ramtuc/rp2040-logic-analyzer/hardware/out/a1/drc-summary.md

# DRC（kicad-cli pcb drc --severity-all --refill-zones）

- 基板: `hardware\rp2040-logic-analyzer.kicad_pcb`
- 未配線: **0**

| severity | type | 件数 |
|:--|:--|--:|
| warning | silk_edge_clearance | 5 |
| warning | silk_over_copper | 8 |
| warning | silk_overlap | 34 |
