ramtuc/rp2040-logic-analyzer/KICAD-KIT.md

# RP2040 ロジックアナライザ — KiCad 着手キット

`SPEC.md` §4〜§10 の確定部品を、KiCad 10 で回路図を描き始められる状態にするための準備資料。**この文書は回路図そのものではない。** 部品の所在・製造制約・ネット名・描き終わったあとの自己点検までを揃える。

- 対象 KiCad: **10.0**（`C:\Program Files\KiCad\10.0`。所在表は**このインストールの実ファイルを直接検索して確認した**もので、他バージョンでは名前が違うことがある）
- 取り込んだライブラリ: `E:\prog\rp2040-logic-analyzer\lib\`
- KiCad プロジェクト: `hardware/rp2040-logic-analyzer.kicad_pro`（**回路図第 1 版は生成スクリプト `tools/gen_schematic.py` の出力**。kicad-cli 10.0.3 の ERC = error 0 / warning 0・§4.1 のネット 86 本と照合 86/86。再現手順は README）
- 作成日: 2026-09-09 ／ **更新: 2026-09-20**（回路図第 1 版 `hardware/rp2040-logic-analyzer.kicad_sch` の実態に合わせて §1.1・§1.2.1・§1.2.4・§1.3・§1.4・§1.5・§2.1・§4.1・§4.2・§5-15・§7 を改訂）

---

## 1. 部品ライブラリ所在表

### 1.1 KiCad 10 標準ライブラリで足りる部品

**シンボルもフットプリントも標準にある。** 追加作業は不要。`FP` 欄に「既定」と書いたものは、シンボルの Footprint プロパティに最初から入っているので、シンボルを置くだけでフットプリントも決まる。

| SPEC BOM # | 参照 | 部品 | シンボル | フットプリント |
|:---|:---|:---|:---|:---|
| 1 | U1 | RP2040 | `MCU_RaspberryPi:RP2040` | `Package_DFN_QFN:QFN-56-1EP_7x7mm_P0.4mm_EP3.2x3.2mm`（**既定**） |
| 2 | U2 | W25Q128JVSIQ | `Memory_Flash:W25Q128JVS` | `Package_SO:SOIC-8_5.3x5.3mm_P1.27mm`（**既定**。SOIC-8 **208mil** の実体。150mil の `SOIC-8_3.9x4.9mm` と間違えないこと） |
| 4 | U7 | AMS1117-3.3 | `Regulator_Linear:AMS1117-3.3` | `Package_TO_SOT_SMD:SOT-223-3_TabPin2`（**既定**） |
| 5 | U8 | USBLC6-2SC6 | `Power_Protection:USBLC6-2SC6` | `Package_TO_SOT_SMD:SOT-23-6`（**既定**） |
| 6 | X1 | ABM8-272-T3 12MHz | `Device:Crystal_GND24`（4 端子・GND が 2/4 番） | `Crystal:Crystal_SMD_3225-4Pin_3.2x2.5mm` |
| 7 | J1 | USB-C 16P（C165948） | `Connector:USB_C_Receptacle_USB2.0_16P` | **`Connector_USB:USB_C_Receptacle_HRO_TYPE-C-31-M-12`** ← C165948 の型番そのものが標準にある |
| 8 | J2 | ピンヘッダ 2×16 | `Connector_Generic:Conn_02x16_Odd_Even` | `Connector_PinHeader_2.54mm:PinHeader_2x16_P2.54mm_Vertical` |
| 9, 10 | J3, J4 | ピンヘッダ 1×3 | `Connector_Generic:Conn_01x03` | `Connector_PinHeader_2.54mm:PinHeader_1x03_P2.54mm_Vertical` |
| — | TP1–TP9 | テストパッド（TP1–TP7 = GP16〜22、**TP8 = SWCLK、TP9 = SWDIO**） | `Connector:TestPoint`（**1 点 1 シンボル**・参照子は TP。旧「J5」を改めた・2026-09-20） | `TestPoint:TestPoint_Pad_1.0x1.0mm` |
| 13 | D1–D3 | LED 赤 0603（C2286） | `Device:LED` | `LED_SMD:LED_0603_1608Metric` |
| 14–21 | R1–R27 | 抵抗 0402 | `Device:R` | `Resistor_SMD:R_0402_1005Metric` |
| 22–25 | C1–C24 | コンデンサ 0402 | `Device:C` | `Capacitor_SMD:C_0402_1005Metric` |
| 26 | C25, C26 | コンデンサ 0805 | `Device:C` | `Capacitor_SMD:C_0805_2012Metric` |

**標準では足りないもの（シンボルは自作 `logicana`／フットプリントは型番固有なので取り込みが要る）— 2026-09-20 差し替え**

| SPEC BOM # | 参照 | 部品 | シンボル | フットプリント |
|:---|:---|:---|:---|:---|
| 11 | SW1 | スライドスイッチ C393948 | **`logicana:SW_SP3T_SK13D07VG5`**（自作・§1.2.4。**2 = COM、1/3/4 = スライダ順の接点、5/6 = 固定ラグ**。2026-10-04 実物で訂正） | `lcsc:SW-TH_SK13D07VG5`（**取り込み**・§1.2。シンボルの Footprint プロパティに設定済み） |
| 12 | SW2, SW3 | タクトスイッチ C318884 | **`logicana:SW_Push_TS1187A`**（自作・§1.2.4。**1+2 と 3+4 が内部導通の 4 パッド**） | `lcsc:SW-SMD_4P-L5.1-W5.1-P3.70-LS6.5-TL_H1.5`（**取り込み**・§1.2。同上） |

> 標準の `Switch:SW_SP3T` / `Switch:SW_Push` は**使わない**。ERC を通ったまま配線が壊れる（理由は §1.2.4）。

### 1.2 標準に無い／LCSC から取り込んだ部品

**不足はシンボル 3（TXU0104PWR・スイッチ 2 種）＋ 型番固有フットプリント 2（スイッチ 2 種）。シンボル 3 個はすべて自作に切り替えた**（§1.2.1・§1.2.4）。残る 2 件（スイッチのフットプリント）は `easyeda2kicad` で取り込む。

**取り込んだファイルの置き場は `lib/lcsc/` に移した。ここは `.gitignore` 済みで、公開リポジトリには入らない**（理由は §1.5）。KiCad からは通常どおり参照できる。

| LCSC | 部品 | 取り込んだシンボル | 取り込んだフットプリント | 実測パッド数 |
|:---|:---|:---|:---|--:|
| **C318884** | タクトスイッチ（SW2, SW3） | `lcsc:TS-1187A-B-A-B` | **`lcsc:SW-SMD_4P-L5.1-W5.1-P3.70-LS6.5-TL_H1.5`** ← 必要 | 4（SMD・5.1×5.1mm） |
| **C393948** | スライドスイッチ（SW1） | `lcsc:SK13D07VG5` | **`lcsc:SW-TH_SK13D07VG5`** ← 必要 | 6（**スルーホール**・信号 4 ＋ 固定ラグ 2） |
| C2286 | LED 赤 0603 | `lcsc:KT-0603R` | `lcsc:LED-SMD_L1.6-W0.8-R-RD` | 2 |
| C165948 | USB-C 16P | `lcsc:TYPE-C-31-M-12` | `lcsc:USB-C_SMD-TYPE-C-31-M-12_1` | 18（信号 16 ＋ 固定 2） |

> **LED と USB-C は標準ライブラリを使うこと。** 取り込んだのは照合用。KiCad 標準の `LED_SMD:LED_0603_1608Metric` と `Connector_USB:USB_C_Receptacle_HRO_TYPE-C-31-M-12` の方がクリアランス・シルク・3D の品質が高い。**`lcsc:` から実際に使うのはスイッチ 2 種のフットプリントだけ。**

### 1.2.1 TXU0104PWR のシンボルは自作した

LCSC 由来のファイルを公開リポジトリに同梱しない方針（§1.5）になったので、**本命の TXU0104PWR は TI データシートから自分で起こした**。格納先は `lib/logicana.kicad_sym`（**`lib/` 配下ではこのファイルだけが追跡対象**）。2026-09-20 の回路図第 1 版で、このファイルに**スイッチ 2 種のシンボル（§1.2.4）と電源シンボル `VREF`** を追記し、計 4 シンボルになっている。

| 項目 | 内容 |
|:---|:---|
| シンボル | **`logicana:TXU0104PWR`** |
| フットプリント | **`Package_SO:TSSOP-14_4.4x5mm_P0.65mm`（KiCad 標準）** をプロパティに設定済み |
| 出典 | TI **SCES937B**（2026-02 改訂）**Table 4-1**「PW, BQA」列 |

**ピン配置（TI Table 4-1 そのまま）**

| ピン | 1 | 2 | 3 | 4 | 5 | 6 | 7 | 8 | 9 | 10 | 11 | 12 | 13 | 14 |
|:---|:--|:--|:--|:--|:--|:--|:--|:--|:--|:--|:--|:--|:--|:--|
| 名前 | VCCA | A1 | A2 | A3 | A4 | NC | GND | OE | NC | B4Y | B3Y | B2Y | B1Y | VCCB |
| 種別 | power_in | input | input | input | input | no_connect | power_in | input | no_connect | output | output | output | output | power_in |

**確認の取り方（再現できる）**

1. `kicad-cli sym upgrade lib/logicana.kicad_sym` → **「シンボル ライブラリは更新されていません」**＝ KiCad 10 が現行形式として問題なく読めている（構文エラーなら失敗する）
2. `kicad-cli sym export svg --symbol TXU0104PWR lib/logicana.kicad_sym` → 描画まで通る
3. 14 ピン全部の `number` / `name` / 電気的タイプを上の表と機械的に突き合わせ、**14/14 一致・番号の重複なし**を確認済み

**フットプリントは TI の推奨ランドと照合済み。**

| | TI PW0014A 推奨ランド（図面 4220202/B） | KiCad `TSSOP-14_4.4x5mm_P0.65mm` |
|:---|:---|:---|
| ピッチ | **0.65mm** | **0.65mm**（一致） |
| パッド寸法 | 0.45 × 1.5mm | 0.40 × 1.475mm |
| 列間（中心‐中心） | 5.8mm | 5.725mm |

KiCad 側は IPC-7351 の公称値で **TI の例より 0.05〜0.075mm 小さいだけ**。TI 自身が図面注記 6 で「Publication IPC-7351 may have alternate designs」と書いており、**そのまま使ってよい**。

### 1.2.2 SW1（C393948 / SK13D07VG5）— データシートで 3 点確定した

前回「パッド間隔が非対称で怪しい」と保留にしていた件を、メーカー図面（首韩科技 SK13D07VG5・図面 2021-06-09 版・LCSC 配布 PDF）で確定させた。

| 論点 | 結論 |
|:---|:---|
| **非対称なパッド間隔は正しい** | 図面の `P.C.B LAYOUT BOTTOM VIEW` と端子側面図の寸法連鎖が **4 / 2 / 2mm（4 ピンで全長 8mm）**。取り込んだフットプリントの x = −4.00 / 0.00 / +2.00 / +4.00 と**完全一致**。固定ラグを含めた全幅は 12.3mm。**修正不要** |
| ~~コモンはピン 1~~ → **コモンはピン 2（2026-10-04 実物で訂正）** | 当初は、図面の `SCHEMATIC (SHORTING)` で左端の端子だけが実線でスライダにつながり、ピン 1 だけが隣から 4mm 離れて残り 3 本が 2mm ピッチ（スライダの移動量）で並ぶ配置と符合する、と読んだ。**実物をテスターで当てるとコモンはピン 2（孤立したピン 1 の隣）**で、スライダ位置ごとにピン 2 がピン 1 / 3 / 4 とつながる。図の読み取りも配置からの推論も外れていた（SPEC §17） |
| **shorting（make-before-break）型** | 図のタイトルが **`SCHEMATIC (SHORTING)`**。→ §1.2.3 の設計上の制約につながる |
| 実装形態 | **THT・ライトアングル**。SPEC §10 の「SMD」は誤りだったので修正済み。手はんだ組（ピンヘッダ 3 点 ＋ SW1 の計 4 点）に入れた |

**SMD の SP3T に替えなかった理由**は SPEC §10 末尾の注記のとおり。候補（MSK13C02 / C2681567・在庫 18,966・$0.1164）はあったが、**コモンがどのピンか・shorting かどうかがデータシートから読み取れない**ため採らなかった。

### 1.2.3 SW1 が shorting 型であることの帰結 ★見落とすと壊れる

**切り替えの途中で隣り合う 2 接点が短絡する。** VREF の 3 択は電源レールを選ぶ回路なので、接点の並べ方を間違えると **+3V3（LDO 出力）と +5V（USB VBUS）が直結**する。3.3V レールは LDO が電流を吸えないので押し上げられ、**RP2040 の IOVDD 絶対最大定格 3.63V を超えうる**。

**対策は接点の並び順だけ。部品代は 0 円。**

```
pad (physical):  1        2        3        4
net:             +3V3     VREF     EXT(J3)  +5V
role:            throw    COM      throw    throw

slider position   COM(pad2) connects to
"3.3V"            pad1 = +3V3      <- end
"EXT"             pad3 = EXT (J3)  <- in the middle
"5V"              pad4 = +5V       <- end
```

> **2026-10-04 訂正**: 第 1 版はピン 1 = コモン（ピン 2 = +3V3）としてこの図を描いていた。実物はピン 2 がコモン（§1.2.2）。上の図が正しい割り当てで、スライダ順「3.3V ― EXT ― 5V」の意図は変わらない。A0 基板は部品側のジャンパで改修済み、PCB は次版で直す（SPEC §17）

こうすれば **+3V3 と +5V は決して隣り合わない**。橋渡しが起きるのは「3V3 ↔ EXT」と「EXT ↔ 5V」で、EXT は未接続が既定なので実害が無い。**EXT に外部電源を挿したままスライドさせない**ことだけシルクか記事で伝える。

> **2026-09-20 追記（回路図レビュー #3）**: この「EXT に外部電源を挿したままスライドさせない」は、EXT を真ん中に置いても解消しない制約（EXT 接続中の切替では、途中で外部電源と内蔵 3.3V または 5V が一時的に直結する。外部電源への逆流も防げない）。**SPEC §6.1「使い方」に運用制約として格上げ**した。手順は「J3 の EXT ケーブルを外す → SW1 で位置を選ぶ → 接続する」。通電中の切替を許容するなら次リビジョンで non-shorting 型か逆流防止を入れる。**初版は回路を変えない**（人間決定）。

### 1.2.4 スイッチのシンボルは自作に差し替えた（2026-09-20・回路図第 1 版で確定）

KiCad 標準の `Switch:SW_SP3T` / `Switch:SW_Push` を §1.2 のフットプリントと組み合わせると、**ERC を通ったまま配線が壊れる**。シンボルのピン番号がそのままパッド番号に対応するので、番号付けが現物のパッド配置と食い違う部品では誤配線が ERC に出ない。

| 参照 | 標準シンボルの問題 | 自作シンボル（`lib/logicana.kicad_sym`） |
|:---|:---|:---|
| SW1 | `Switch:SW_SP3T` は**コモンがピン 3**（描画で確認: 左の単独ピンが 3、右が 1/2/4）。物理はピン 2 がコモン（§1.2.2・2026-10-04 実物で訂正）なので、番号どおり繋ぐと**コモンがパッド 3 に行く** | **`SW_SP3T_SK13D07VG5`** — ピン番号 = 物理パッド番号。**2 = COM、1/3/4 = スライダ順の接点、5/6 = 固定ラグ（MNT・未接続）**。接続は pin2 = `VREF` / pin1 = `+3V3` / pin3 = `VREF_EXT` / pin4 = `+5V`（§5-12 の並びどおり）。**2026-10-04 訂正**: 回路図第 1 版は 1 = COM として pin1 = `VREF` / pin2 = `+3V3` で描いており、実物ではコモンが +3V3 側になっていた。シンボルのピン番号を実物に合わせて直した（配線は不変） |
| SW2, SW3 | `Switch:SW_Push` は 2 ピン。TS-1187A は 4 パッドで、**パッド 1–2（A–B）が内部で常時導通、3–4（C–D）が反対側**（XKB 図面 TS-1187A-X-X-X の回路図・LCSC 配布 PDF で確認。EasyEDA シンボルの A–B 結線とも一致）。2 ピンシンボルを 4 パッドに当てるとピン 1/2 → パッド 1/2 になり、**押していなくても常時短絡**（RUN / BOOT が GND に張り付く＝永久リセット） | **`SW_Push_TS1187A`** — 1+2 を同一点に、3+4 を同一点にスタックした 4 ピン。4 パッド全部にネットが付き、接点の対（1+2 ↔ 3+4）だけがスイッチになる |

どちらも `ki_fp_filters` を `lcsc` のフットプリント名に合わせ、Footprint プロパティに §1.2 の型番固有フットプリントを設定済み。`kicad-cli sym upgrade`（「更新されていません」＝ 10.0 形式として正常）と `sym export svg`（3/3 成功）で読めることを確認している。LCSC 由来のシンボル（`lcsc:SK13D07VG5` / `lcsc:TS-1187A-B-A-B`）は照合にだけ使い、回路図には埋め込まない（§1.5 の方針）。

### 1.3 取り込みを再現する手順

```
py -m pip install --user easyeda2kicad          # 導入済み: v1.0.1
```

必要なのは**スイッチ 2 種のフットプリント**。LED と USB-C は照合用（標準ライブラリを使うので任意）。

```
py -m easyeda2kicad --full --project-relative --lcsc_id C318884 --output E:/prog/rp2040-logic-analyzer/lib/lcsc/lcsc --overwrite
py -m easyeda2kicad --full --project-relative --lcsc_id C393948 --output E:/prog/rp2040-logic-analyzer/lib/lcsc/lcsc --overwrite
py -m easyeda2kicad --full --project-relative --lcsc_id C2286   --output E:/prog/rp2040-logic-analyzer/lib/lcsc/lcsc --overwrite
py -m easyeda2kicad --full --project-relative --lcsc_id C165948 --output E:/prog/rp2040-logic-analyzer/lib/lcsc/lcsc --overwrite
```

`--full` で **シンボル・フットプリント・3D モデル（wrl と step 両方）** が出る。`--output` はライブラリ名の接頭辞で、次の 3 つが作られる。

```
lib/lcsc/lcsc.kicad_sym      シンボル（全部品が 1 ファイルに追記される）
lib/lcsc/lcsc.pretty/        フットプリント（1 部品 1 ファイル）
lib/lcsc/lcsc.3dshapes/      3D モデル
```

> **`--project-relative` を必ず付ける。** 付けないと 3D モデルのパスが**絶対パスで埋め込まれ**、リポジトリを別の場所に置いた瞬間に 3D が出なくなる。付ければ `${KIPRJMOD}/lib/lcsc/lcsc.3dshapes/...` になる（取り込み済みのものは確認済み）。**ただしプロジェクトは `hardware/` 配下なので（§1.4）、フットプリントを基板に取り込む段でこのパスを `${KIPRJMOD}/../lib/lcsc/lcsc.3dshapes/...` に書き換える。** 3D 表示だけの問題で製造データには影響しない。

> **必須の後処理**: easyeda2kicad v1.0.1 が書き出すフットプリントは **KiCad 5 時代の `(module ...)` 形式**（`tedit` 付き）。KiCad 10 でも読めるが、そのままだと保存のたびに変換が走る。**一度だけ次を実行して KiCad 10 形式に上げておく**（実行済み・戻り値 0、`(footprint ... (version 20260206))` に変換されたことを確認済み）。
>
> ```
> "C:\Program Files\KiCad\10.0\bin\kicad-cli.exe" fp  upgrade E:\prog\rp2040-logic-analyzer\lib\logicana.pretty
> "C:\Program Files\KiCad\10.0\bin\kicad-cli.exe" sym upgrade E:\prog\rp2040-logic-analyzer\lib\logicana.kicad_sym
> ```

### 1.4 ライブラリの登録

プロジェクトは **`hardware/rp2040-logic-analyzer.kicad_pro`**（リポジトリ直下ではなく `hardware/` 配下・2026-09-20 確定）。登録は**プロジェクト固有**（グローバルではない）で、`hardware/sym-lib-table` と `hardware/fp-lib-table` に生成済み。`${KIPRJMOD}` が `hardware/` を指すので、パスはすべて **`${KIPRJMOD}/../lib/...`** になる。

| 種別 | メニュー | ニックネーム | パス | git |
|:---|:---|:---|:---|:---|
| シンボル（**自作**） | 設定 → シンボルライブラリを管理 → **プロジェクト固有**タブ | `logicana` | `${KIPRJMOD}/../lib/logicana.kicad_sym` | **追跡する** |
| シンボル（LCSC 由来） | 同上 | `lcsc` | `${KIPRJMOD}/../lib/lcsc/lcsc.kicad_sym` | `.gitignore` |
| フットプリント（LCSC 由来） | 設定 → フットプリントライブラリを管理 → **プロジェクト固有**タブ | `lcsc` | `${KIPRJMOD}/../lib/lcsc/lcsc.pretty` | `.gitignore` |

3D モデルのパスも同じく `${KIPRJMOD}/../lib/lcsc/lcsc.3dshapes/...` にする。easyeda2kicad が埋め込むのは `${KIPRJMOD}/lib/...`（ルート前提）なので、**フットプリントを基板に取り込む段で `../` を足す**（§1.3）。`${KIPRJMOD}` 相対である限り、リポジトリを別の場所へ移しても壊れない。

### 1.5 ライセンス — **2026-09-09 に方針確定**

**LCSC / EasyEDA 由来のファイルは公開リポジトリに同梱しない。** そのために本命の TXU0104PWR は自作に切り替え（§1.2.1）、残りは `lib/lcsc/` にまとめて `.gitignore` した。README に取り込みコマンドを載せてあるので、読者は自分で生成できる。

| 対象 | ライセンス | この基板での扱い |
|:---|:---|:---|
| **KiCad 標準ライブラリ**（symbols / footprints / 3dmodels） | **CC-BY-SA 4.0 ＋ 例外条項** | 公式 License ページが「ライブラリを使って作った電子設計が Adapted Material に当たるとしても著作権者は権利を放棄する」旨を明記しており、**この基板を CERN-OHL-P-2.0 で出すことと衝突しない**。ただし**ライブラリ自体を再配布するなら CC-BY-SA 4.0 と帰属表示が必要**。→ **`lib/` に標準ライブラリのコピーを置かない**（参照するだけ） |
| **`lib/logicana.kicad_sym`（TXU0104PWR・SW_SP3T_SK13D07VG5・SW_Push_TS1187A・VREF の 4 個・自作）** | **この基板と同じ CERN-OHL-P-2.0** | TI SCES937B Table 4-1 とメーカー図面（SK13D07VG5 / TS-1187A）のピン割り当てを読んで自分で描いたもの。**追跡・同梱する** |
| **easyeda2kicad.py**（ツール） | **AGPL-3.0**（パッケージメタデータで確認） | ツールを実行しただけで出力物にライセンスは及ばない |
| **`lib/lcsc/`（LCSC / EasyEDA 由来）** | **明示的なオープンライセンスを確認できなかった（未確認）** | **`.gitignore` 済み・同梱しない。** 読者は README のコマンドで各自生成する |
| **3D モデル（`.step` / `.wrl`）** | 同上 | **同梱しない**（`lib/lcsc/` ごと除外）。容量も 14MB あり、リポジトリに載せる意味が薄い |

---

## 2. JLCPCB PCBA 用の BOM / CPL を KiCad から出す

### 2.1 まずシンボルにフィールドを足す

**回路図を描き始める前に決めておくと後で全部品を触り直さずに済む。** JLCPCB 公式の KiCad 10 向け記事は、フィールド名を **`LCSC Part #`** にせよと書いている（「Click the (Add Field) button on the left and create a field named **LCSC Part #**」）。

`Fabrication Toolkit`（bennymeg）は README のとおり、次の順で探す。**公式記事に合わせて `LCSC Part #` を使えば両方の経路で通る。**

| 優先 | フィールド名 |
|:---|:---|
| 1（主） | `LCSC Part #` / `LCSC Part` / `LCSC PN` / `LCSC P/N` / `LCSC Part No.` / `LCSC Part Number` |
| 1（主） | `JLCPCB Part #` ほか同型 |
| 2（代替） | `LCSC` / `JLC` / `MPN` / `Mpn` / `mpn` |

> **DNF 部品**（R23 の QSPI_SS プルアップ、J4 の DNF）は `LCSC Part #` を**空にする**か、シンボルプロパティの **Do not populate (DNP)** を立てる。Fabrication Toolkit には「Exclude DNP components from BOM」のオプションがある。

**フィールド名は `LCSC Part #` に統一する（2026-09-20 確定）。** 回路図第 1 版は全部品にこの名前で入れてあり、kicad-cli の `sch export bom --fields "Reference,Value,Footprint,LCSC Part #,QUANTITY,DNP"`（経路 B 相当・README の再現手順）でも列に出ることを確認済み。R23 は DNP ＋ `LCSC Part #` 空、J4 も DNP で、JLCPCB 向け `bom-jlcpcb.csv` からは除外される。

### 2.2 出力の 2 経路

| | 経路 A: **Fabrication Toolkit**（推奨） | 経路 B: KiCad 10 標準機能のみ |
|:---|:---|:---|
| BOM | プラグインが自動生成 | 回路図エディタ → **ツール → シンボルフィールドテーブルを編集** → **エクスポート**タブ → Format presets を **CSV** |
| CPL | プラグインが `positions.csv` を生成 | PCB エディタ → **ファイル → 基板製造用ファイル出力 → 部品配置ファイル (.pos)**。単位 **mm**、**CSV**、両面を 1 ファイル |
| 回転補正 | **自動**（後述） | **手動**。JLCPCB 公式記事は経路 B について回転補正の手順を書いていない |
| ガーバー | 同時に出る | 別途出力 |

JLCPCB が要求する列名（公式記事より）:

- **BOM**: `Comment` / `Designator` / `Footprint` / `JLCPCB Part #`
- **CPL**: `Designator` / `Mid X` / `Mid Y` / `Rotation` / `Layer`（**mm・回転は反時計回りが正**）

### 2.3 フットプリントの原点と回転のずれ — 補正は要るのか

**要る。ただし手作業ではなく仕組みで吸収する。**

JLCPCB 側の前提は「**PCB ライブラリのゼロ度の向きが、テープ／リールに入っている部品の向きと一致していること**」。KiCad 標準ライブラリはこの前提に合っていない部品が多いので、そのまま CPL を出すと極性部品（LED・ダイオード・IC）が 90° / 180° ずれる。

| 手段 | 内容 |
|:---|:---|
| **Fabrication Toolkit の自動補正**（これを使う） | README に「Most of the rotations may be corrected by the **`rotations.cf`** definitions」。プラグイン内蔵の補正データベースが、フットプリント名の正規表現で回転量を当てる |
| 例外が出たとき | シンボルに **`FT Rotation Offset`** フィールドを足し、**反時計回りの度数**を入れる（代替名 `Rotation Offset` / `RotOffset`） |
| 位置がずれるとき | **`FT Position Offset`** に `x,y` をカンマ区切り・mm で入れる（代替名 `Position Offset` / `PosOffset`） |
| 原点そのものを変えたいとき | **`FT Origin`** に `Anchor` または `Center` |
| JLCPCB 標準機能の逃げ道 | 公式が「向きが分からなければ JLCPCB のエンジニアがシルクの表示を見て組み立て前に回転と極性を直す」と書いている。**最後の保険であって、当てにして出すものではない** |
| 経路 B を使う場合 | 「**Apply automatic component translations** にチェックを入れたままにする（JLCPCB 向けに部品の回転／位置を直す）」と公式記事が書いている |

> **今回この基板で特に危ないのは 3 つ。** ①**LED（D1–D3）の極性** — 0603 LED は補正データベースの常連。②**USB-C（J1）** — 標準の `USB_C_Receptacle_HRO_TYPE-C-31-M-12` は原点がコネクタ中心で、LCSC のテープ向きと一致する保証が無い。③**AMS1117（SOT-223）** — タブの向き。**この 3 つは、発注前に JLCPCB の注文画面の 3D プレビューで必ず目視すること。** ガーバーをアップロードすると部品の向きが表示される。

---

## 3. JLCPCB 4 層の製造能力と KiCad の Board Setup

### 3.1 スタックアップ（Board Setup → 基板スタックアップ）

JLCPCB 公式のインピーダンス用スタックアップ一覧より、**1.6mm 4 層の標準は `JLC04161H-7628`**。KiCad の物理スタックアップにそのまま入れる値:

| 層 | 材料 | 厚み | 誘電率 Dk |
|:---|:---|--:|--:|
| F.Cu | 銅 1oz | **0.035mm** | — |
| Dielectric 1 | **プリプレグ 7628 ×1** | **0.2104mm** | **4.4** |
| In1.Cu | 銅 0.5oz | **0.0152mm** | — |
| Dielectric 2 | **コア** | **1.065mm** | **4.6** |
| In2.Cu | 銅 0.5oz | **0.0152mm** | — |
| Dielectric 3 | **プリプレグ 7628 ×1** | **0.2104mm** | **4.4** |
| B.Cu | 銅 1oz | **0.035mm** | — |
| | | **合計 1.586mm ≒ 1.6mm** | |

同じ 1.6mm 4 層で選べる別案（プリプレグが薄くなる＝外層と GND が近づく）:

| 名前 | 外層プリプレグ | Dk | コア |
|:---|--:|--:|--:|
| `JLC04161H-7628` ✅ | 0.2104mm | 4.4 | 1.065mm |
| `JLC04161H-2116` | 0.1164mm | 4.16 | 1.265mm |
| `JLC04161H-3313` | 0.0994mm | 4.1 | 1.265mm |
| `JLC04161H-1080` | 0.0764mm | 3.91 | 1.265mm |

**`JLC04161H-7628` を選ぶ。** 公式が「計算機が最初に薦めるスタックアップが最も安く納期も早い」と書いており、7628 が既定。プリプレグが薄い案は USB の線幅が細くなりすぎる。

> **層の役割**: L1 = 部品と信号 ／ **L2 = 切れ目のない GND ベタ** ／ L3 = 電源（+3V3・+5V・VREF） ／ L4 = 信号と GND。SPEC §8.1 の「16 本の高速入力の下に切れ目のない GND」は L2 が担う。

### 3.2 Design Rules（Board Setup → デザインルール → 制約）

JLCPCB 公式 capabilities ページの多層基板・外層 1oz の値。**括弧内はこの基板で実際に入れる推奨値**（最小値ぎりぎりで引くと歩留まりと DFM 指摘のリスクが上がるので、余裕を取る）。

| KiCad の項目 | JLCPCB の限界 | **入れる値** |
|:---|:---|:---|
| 最小クリアランス | 0.09mm（3.5mil・1oz 多層） | **0.15mm** |
| 最小トラック幅 | 0.09mm（3.5mil・1oz 多層） | **0.15mm** |
| 最小ビア直径 | 0.25mm | **0.45mm** |
| 最小ビアドリル | 0.15mm | **0.25mm** |
| 最小スルーホール径 | 0.15mm（ドリル範囲 0.15〜6.3mm） | **0.30mm** |
| 最小アニュラリング | 0.15mm（**推奨 0.20mm 以上**） | **0.10mm**（＝ビア 0.45／ドリル 0.25 で片側 0.10mm。**JLCPCB の推奨 0.20mm を満たすなら 0.65/0.25 にする**） |
| 最小シルク線幅 | ≥0.15mm | **0.15mm** |
| 最小ソルダーマスクダム（ブリッジ） | 0.10mm（1oz） | **0.10mm** |
| 基板端からの銅箔クリアランス | ≥0.2mm | **0.3mm** |
| 銅厚 | 外層 1oz / 2oz、内層 0.5oz（既定）/ 1oz / 2oz | **外層 1oz・内層 0.5oz** |
| トラック幅公差 | ±20% | — |
| 穴位置公差 | ±0.05mm | — |

> **未取得**: 「穴と穴の最小間隔」「ビアとトラックの最小間隔」は capabilities ページの取得範囲に無かった（**未確認**）。ガーバーを上げると走る **JLCPCB の DFM チェックで確認する**のが確実。

### 3.3 ネットクラス（Board Setup → デザインルール → ネットクラス）

| ネットクラス | 対象ネット | トラック幅 | クリアランス | ビア径/ドリル | 差動 |
|:---|:---|--:|--:|:---|:---|
| `Default` | 上記以外 | 0.20mm | 0.15mm | 0.45/0.25 | — |
| `Power` | `+5V` `+3V3` `VREF` `DVDD` | **0.50mm** | 0.20mm | 0.65/0.35 | — |
| `USB` | `USB_DP` `USB_DM`（コネクタ側） | **0.30mm** | 0.15mm | 使わない | **幅 0.30mm / ギャップ 0.15mm** |
| `Signal_D` | `D0`〜`D15` | 0.20mm | 0.15mm | 0.45/0.25 | — |
| `QSPI` | `QSPI_SCLK` `QSPI_SS_N` `QSPI_SD0`〜`SD3` | 0.20mm | 0.15mm | 使わない | — |

### 3.4 USB 2.0 の 90Ω 差動ペア

**Raspberry Pi 公式の前提**（Hardware design with RP2040 §2.4.1）:

> 「RP2040 はフルスピード 12Mbps に限られるとはいえ、伝送線路の特性インピーダンスを USB 規格の **90Ω（差動）**に近づけるべきである。**この 1mm 厚の基板では、USB_DP / USB_DM に 0.8mm 幅、間隔 0.15mm を使えば約 90Ω になる**」
> 「**1mm より厚い基板を選ぶ場合**は、トラックと直下の GND の距離が増えた分を**再設計するか**、無視して祈るかの二択になる」

**この基板は 1.6mm 4 層なので「再設計する」側。** ただし 2 層 1mm と違い、**外層のすぐ下（0.2104mm）に L2 の GND ベタが来る**ので、距離はむしろ**縮む**。したがって公式の 0.8mm より**細くなる**。

`JLC04161H-7628` の外層（H = 0.2104mm、Dk = 4.4、銅 0.035mm）でエッジ結合マイクロストリップとして計算した値:

| 間隔 S | 90Ω 差動になる幅 W | そのときの単線 Z0 |
|--:|--:|--:|
| 0.13mm | 0.283mm | 61.2Ω |
| **0.15mm** | **0.300mm** | 59.4Ω |
| 0.20mm | 0.336mm | 55.7Ω |
| 0.25mm | 0.365mm | 53.2Ω |

**採用: 幅 0.30mm / 間隔 0.15mm。** 参考までに、同じ層で 50Ω 単線にするなら 0.405mm。

> **この 4 つの数字は自分で計算した参考値であって、JLCPCB の公式値ではない。** IPC-2141 系のマイクロストリップ近似（Hammerstad ＋ 差動補正）で解いたもので、実装誤差やソルダーレジストの影響は入っていない。
>
> **公式のインピーダンス計算機との突き合わせはできなかった（未確認・2026-09-09）。** `jlcpcb.com/pcb-impedance-calculator` は入力も計算もブラウザ側で完結する SPA で、HTML にも読み込まれる JS にも**照会できる API が無い**。値を取るには実際にブラウザで操作するしかない。**発注前に人間が計算機に「4 層・1.6mm・差動・トップ層・90Ω」を入れて突き合わせること。**
>
> **そのうえで、今回は「インピーダンス制御」を注文しない前提でよい。** 相手は 12Mbps のフルスピードで、Raspberry Pi 公式自身が「USB FS はかなり寛容」と書いている。制御を注文すると費用と納期が増える。**やるべきは「線幅を合わせる」「直下を GND ベタだけが通るようにする」の 2 点**で、これは無料。仮に実測が 90Ω から 1 割ずれても FS では実害が出ない。

---

### 3.5 PCBA 側の制約（JLCPCB 公式 assembly capabilities）

| 項目 | Economic PCBA | 備考 |
|:---|:---|:---|
| 最小部品サイズ | **0402** | この基板の最小は 0402。**ぎりぎり通る**（Standard なら 0201 まで） |
| スルーホール部品 | **対応する**（SMD ＋ THT の混載も可） | SW1・J2〜J4 が該当。ただし手はんだ工賃は SPEC §14-5 の判断どおり |
| 実装面 | 片面 / 両面 | **片面（top のみ）で設計する**。両面にすると費用が増える |
| 基板サイズ | 10×10mm 〜 470×500mm | SPEC §8.3 のサイズなら問題なし |
| 面付けレール | **不要** | Standard PCBA だと必要になる |

---

## 4. ネット名とシート構成

### 4.1 ネット名（SPEC §7 のピン割り当てをそのまま名前にする）

**1ch あたりネットが 3 本になる**（ヘッダ → 100Ω → TXU0104 A ピン → B ピン → RP2040）。名前を機械的に決めておくと、フロントエンドのシートを 4 回使い回すときに迷わない。

| 区間 | ネット名 | 本数 | 行き先 |
|:---|:---|--:|:---|
| J2 の内側 1 列 → R（100Ω） | `CH0_IN` 〜 `CH15_IN` | 16 | プローブが刺さる先 |
| R（100Ω） → TXU0104 の A ピン | `CH0_A` 〜 `CH15_A` | 16 | A1〜A4 ×4 個 |
| TXU0104 の B ピン → RP2040 | **`D0` 〜 `D15`** | 16 | **GP0〜GP15**（ファームのチャンネル番号と一致させる） |

| 用途 | ネット名 | 接続先 |
|:---|:---|:---|
| USB VBUS | `+5V` | J1 VBUS → SW1 の 5V 接点、AMS1117 IN |
| 3.3V レール | `+3V3` | AMS1117 OUT。RP2040 IOVDD ×6・USB_VDD・ADC_AVDD、TXU0104 の VCCB ×4 |
| **A 側基準電圧** | **`VREF`** | SW1 コモン → TXU0104 の VCCA ×4、D2 |
| RP2040 内蔵レギュレータ出力 1.1V | `DVDD` | VREG_VOUT(45) → DVDD(23, 50) |
| USB（RP2040 側・27Ω より内側） | `USB_DP_MCU` `USB_DM_MCU` | RP2040 ↔ R19 / R20 |
| **USB（コネクタ側・長い方）** | **`USB_DP` `USB_DM`** | R19 / R20 ↔ USBLC6 ↔ J1。**ネットクラス `USB` を当てるのはこちら** |
| USB-C の CC | `CC1` `CC2` | 5.1kΩ で GND（**各 1 本・独立**） |
| 水晶 | `XIN` `XOUT`（1kΩ の外側は `XTAL_DRV`） | RP2040 ↔ R21 ↔ X1 |
| フラッシュ | `QSPI_SCLK` `QSPI_SS_N` `QSPI_SD0` 〜 `QSPI_SD3` | RP2040 ↔ U2（直結・最短） |
| BOOTSEL | `USB_BOOT` | SW2 → R22(1kΩ) → `QSPI_SS_N` |
| リセット | `RUN` | SW3 → GND |
| **レベル変換の出力許可** | **`TXU_OE`** | **GP23** ＋ 10kΩ で **`+3V3` へ**プルアップ（§5-10） |
| ステータス LED | `LED_STATUS` | GP25 → R27 → D3 |
| **VREF の外部入力** | **`VREF_EXT`** | SW1 pin3 ↔ J3 pin2（J3 pin1/3 は GND）。2026-09-20 命名 |
| テストパッド | `GP16` 〜 `GP22` | TP1〜TP7（1 点 1 シンボル・7 点） |
| **SWD** | **`SWCLK` `SWDIO`** | U1 pin24 / pin25 → **TP8 / TP9**（2026-09-20 決定・§5-15） |
| アナログ | `GP26_ADC0` `GP27_ADC1` `GP28_ADC2` | J4（DNF） |
| グラウンド | `GND` | 全面。**J1 SHIELD → GND 直結**（Pico と同じ扱い）、**U1 TESTEN(19) → GND**（RP2040 データシートのピン説明「Factory test mode enable. Ground on user boards」） |

### 4.2 階層シート分割案

> **回路図第 1 版（2026-09-20）は平面 1 シート（A3）で生成した。** 結線はローカルラベル（§4.1 の名前そのまま）で決まるので、GUI で整形するときに以下の分割へ移してもネットは変わらない。以下は分割する場合の案。

```
rp2040-logic-analyzer.kicad_sch          ルート（シートシンボルだけを置く）
├── 01_power.kicad_sch                   J1(USB-C) / U8(ESD) / U7(LDO) / SW1(VREF 3択) / D1 / D2
├── 02_mcu.kicad_sch                     U1(RP2040) / U2(Flash) / X1 / SW2 / SW3 / D3 / TP1〜TP9
├── 03_frontend.kicad_sch  ×4 インスタンス  U3〜U6（TXU0104 1 個ぶん = 4ch）
└── 04_connectors.kicad_sch              J2(2×16 プローブヘッダ) / J3(VREF EXT) / J4(アナログ DNF)
```

**フロントエンドは 1 枚のシートを 4 回使い回す。** KiCad は同じ回路図ファイルを複数のシートシンボルから参照でき、注釈（R1 と R5 のような参照子）はインスタンスごとに別々に振られる。**4 回描き写すより間違いが 4 分の 1 になる。**

`03_frontend.kicad_sch` の階層ピン（1 インスタンスあたり 10 本）:

| 階層ピン | 向き | ルート側で繋ぐもの（インスタンス 1 の例） |
|:---|:---|:---|
| `IN0` 〜 `IN3` | input | `CH0_IN` 〜 `CH3_IN` |
| `OUT0` 〜 `OUT3` | output | `D0` 〜 `D3` |
| `VREF` | power in | `VREF` |
| `OE` | input | `TXU_OE` |

`+3V3` と `GND` は電源シンボルで各シートに直接置く（階層ピンにしない）。

| インスタンス | シート名 | IN | OUT |
|:---|:---|:---|:---|
| 1 | `FE_A` (U3) | `CH0_IN`〜`CH3_IN` | `D0`〜`D3` |
| 2 | `FE_B` (U4) | `CH4_IN`〜`CH7_IN` | `D4`〜`D7` |
| 3 | `FE_C` (U5) | `CH8_IN`〜`CH11_IN` | `D8`〜`D11` |
| 4 | `FE_D` (U6) | `CH12_IN`〜`CH15_IN` | `D12`〜`D15` |

> **`CHn_A`（100Ω と A ピンの間）はシートの中で閉じるので、階層ピンに出さない。** シート内ではローカルに `A0`〜`A3` と呼べばよい。

---

## 5. 回路図を描き終えたあとのチェックリスト

**15 項目。ERC を通すだけでは見つからない、「繋がってはいるが間違っている」ものだけを並べた。**

| # | 見るところ | 合格条件 |
|--:|:---|:---|
| 1 | **RP2040 の 100nF** | 公式は「**電源ピン 1 本につき 100nF 1 個**」＝ IOVDD ×6（1, 10, 22, 33, 42, 49）＋ DVDD ×2（23, 50）＋ USB_VDD（48）＋ ADC_AVDD（43）で **10 個**。ただし**公式の Minimal design example は 9 個しか載せていない** — 48 番と 49 番でコンデンサ 1 個を共用しており、文書自身が「ルートを引く場所が足りないための妥協。4 層で両面実装なら避けられる」と書いている。**この基板は 4 層なので 10 個入れる**。BOM の C1–C12 は 2 個の余裕込み（別の 1 個は U2 フラッシュ用）。**すべてピンの直近に置く**（レイアウト時） |
| 2 | **内蔵レギュレータ** | **VREG_VIN(44) と VREG_VOUT(45) に 1µF を各 1 個**（公式が明示的に要求。100nF では不可）。**VREG_VOUT を DVDD(23, 50) に繋いだか。** DVDD を +3V3 に繋いでいないか（繋ぐと壊れる） |
| 3 | **水晶の負荷容量** | **15pF ×2**（XIN 側・XOUT 側）。直列合成 7.5pF ＋ 寄生 3pF ≒ 10.5pF で、ABM8-272-T3 の CL 10pF に合う。**この 15pF は「CL 10pF の水晶」とセットの値**で、水晶を替えたら計算し直す |
| 4 | **水晶のダンピング抵抗** | **1kΩ を 1 本、XOUT と水晶の間（確定・2026-09-09）**。公式 Minimal design example の KiCad 回路図を直接読んで確認した — R5 は (83.82, 227.33)、配線は `水晶 → R5 → XOUT ラベル`、**XIN 側は水晶と直結で抵抗なし**。SPEC §4.3 も修正済み。公式文書の本文には側が書かれていないので、**回路図でしか分からない**部分 |
| 5 | **QSPI_SS のプルアップ** | R23（10kΩ）は **DNF**。W25Q128 なら不要と公式が判断しているが、**フットプリントは必ず置く**（別のフラッシュに替えたら要る）。DNP を立てて `LCSC Part #` を空にする |
| 6 | **BOOTSEL** | SW2 → **R22（1kΩ）** → `QSPI_SS_N`。この 1kΩ が無いと、ブート時に RP2040 が QSPI_SS を安全に押し上げられない。**R22 と R23 はフラッシュの直近**（公式「Both R1 and R2 should be placed close to the flash chip」） |
| 7 | **USB の 27Ω** | `USB_DP` / `USB_DM` に **27Ω を各 1 本、RP2040 の直近**。**プルアップ / プルダウンは付けない**（RP2040 内蔵）。付けると速度判定が壊れる |
| 8 | **USB-C の CC** | **CC1 と CC2 に 5.1kΩ を各 1 本、それぞれ独立に GND へ**。1 本にまとめたり 10kΩ にしたりすると、USB-C の給電側が 5V を出さない |
| 9 | **ESD の位置** | USBLC6-2SC6 は **J1 の直近**。信号の順序が `J1 → USBLC6 → 27Ω → RP2040` になっているか（ESD が 27Ω の内側にあると保護にならない） |
| 10 | **TXU0104 の OE** | TI データシートは「**OE を GND に引けば全出力が Hi-Z、VCCA または VCCB に引けば全出力が有効**」。→ **10kΩ プルアップの行き先は `+3V3`（＝VCCB 側）にする。`VREF` に繋がない。** VREF は EXT 未接続で 0V になり得るため |
| 11 | **TXU0104 の未使用入力とパスコン** | A 入力には**内蔵プルダウンがあるので外付け不要**（TI「Inputs with integrated static pull-down resistors prevent channels from floating」）。**VCCA と VCCB に 100nF を各 1 個 ×4 個 = 8 個**（BOM の C13–C20）。NC ピン（6, 9）はどこにも繋がない |
| 12 | **VREF 切り替えの並び順** ★ | SW1 の**ピン 2 がコモン**＝`VREF`（2026-10-04 実物で訂正）。**ピン 1 = +3V3 / ピン 3 = EXT(J3) / ピン 4 = +5V（スライダ順 3.3V ― EXT ― 5V）で必ず並べる。** SK13D07VG5 は **shorting（make-before-break）型**で、切り替え途中に隣接接点が短絡する。+3V3 と +5V を隣り合わせると **LDO 出力と USB VBUS が直結**し、3.3V レールが RP2040 の絶対最大 3.63V を超えうる。**EXT を真ん中に挟むだけで回避できる**（§1.2.3） |
| 13 | **入力直列抵抗** | R1–R16（100Ω）は **J2 と TXU0104 の A ピンの間**。**1kΩ にしない**（SPEC §5.3: Cio 4pF に対して 100Ω なら 0.4ns、1kΩ だと 4ns で 100MS/s に効く） |
| 14 | **LED 3 個の行き先** | D1 = `+3V3`、D2 = **`VREF`**、D3 = `LED_STATUS`(GP25)。各 1kΩ。**D2 が VREF に付いているのは「スイッチの入れ忘れを目で見る」ため**で、EXT 1.8V では暗くなるのが正常 |
| 15 | **SWD を出すか決める** | **決着（2026-09-20）: 出す。TP8 = `SWCLK`（U1 pin24）、TP9 = `SWDIO`（U1 pin25）のテストパッド 2 点**（銅パッドのみ・部品費 0・ファームのデバッグに要る）。SPEC §6 / §10 に反映済み。回路図第 1 版（commit de18d95）では両ピンが no_connect のままで、再生成で反映する。**`hardware/out/kit5-check.md` の #15 が PASS（SWCLK: TP8+U1 / SWDIO: TP9+U1）になっているか**をここで見る |

> **RUN(26) には外付け部品を足さないこと（2026-09-09 確定）。** RP2040 データシート Table 619 が RUN の Reset State を **Pull-Up** と明記し、ピン説明も「If no external reset is required, this pin can be tied directly to IOVDD」。**公式 Minimal design example にも RUN にはプルアップもコンデンサも付いていない**（ヘッダへ引き出すだけ）。**SW3 で GND に落とすだけで足りる。** チャタリング対策の 100nF を足したくなるが、公式が付けていないので初版では付けない。

---

## 6. 未確認・要決定

| # | 内容 | 状態 |
|--:|:---|:---|
| 1 | **90Ω 差動の幅 0.30mm / 間隔 0.15mm** | 自分の IPC-2141 近似計算。**JLCPCB 公式のインピーダンス計算機とは突き合わせていない（未確認）** — 計算機はブラウザ側で完結する SPA で照会 API が無く、実際にブラウザで操作するしかない。**インピーダンス制御は注文しない前提**なので、外しても致命傷にはならない（§3.4） |
| 2 | **穴と穴の最小間隔／ビアとトラックの最小間隔** | JLCPCB capabilities ページの取得範囲に無かった。**未確認**。ガーバーを上げれば DFM チェックで拾える |
| 3 | ~~SW1 のコモンがピン 1 であること~~ | **確認済み（2026-10-04）: 実物のコモンはピン 2 だった。** データシートの読み取りとパッド配置からの推論は外れ、テスターで位置ごとの導通を当てて判明。A0 は部品側で改修、回路図は修正済み、PCB は次版で直す（SPEC §17） |
| 4 | C9002（X322512MSB4SI）の ESR / CL | SPEC §4.3 のまま。ABM8-272-T3 を採るので初版では問題にならない |
| 5 | RP2040 の設計ファイル側のライセンス | SPEC §16 のまま。**図も回路も自分で描く**方針なので実務上は影響しない |

---

## 7. 決着済みの判断（記録）

| 項目 | 決定 | 日付 |
|:---|:---|:---|
| `lib/` の公開方針 | **LCSC / EasyEDA 由来は同梱しない。** `lib/lcsc/` を `.gitignore`、README に取り込みコマンドを掲載 | 2026-09-09 |
| TXU0104PWR | **TI SCES937B Table 4-1 から自作**し `lib/logicana.kicad_sym` に格納。フットプリントは KiCad 標準 `Package_SO:TSSOP-14_4.4x5mm_P0.65mm` で代用（TI 推奨ランドと照合済み） | 2026-09-09 |
| 3D モデル | **`.step` / `.wrl` は公開リポジトリに載せない。** パスは `--project-relative` で `${KIPRJMOD}` 相対に取り直し済み | 2026-09-09 |
| SW1 | **C393948（THT・SP3T・shorting）を維持**。手はんだ組に追加。接点の並びは 3.3V ― EXT ― 5V | 2026-09-09 |
| 水晶のダンピング抵抗 | **XOUT 側**（公式回路図で確定） | 2026-09-09 |
| RUN(26) | **外付け部品なし**（内蔵プルアップ・公式回路図で確定） | 2026-09-09 |
| スイッチのシンボル | **標準 `Switch:SW_SP3T` / `SW_Push` は使わず、`logicana:SW_SP3T_SK13D07VG5` / `logicana:SW_Push_TS1187A` を自作**（§1.2.4。標準のままだとコモンがパッド 3 に行く／タクト SW が常時短絡） | 2026-09-20 |
| プロジェクトの置き場 | **`hardware/` 配下**。ライブラリのパスは `${KIPRJMOD}/../lib/...`（§1.4） | 2026-09-20 |
| SWD | **出す**。TP8 = SWCLK、TP9 = SWDIO（§5-15） | 2026-09-20 |
| VREF のバルク容量 | **C27 1µF（C21/C22 と同部品）を VREF–GND・SW1 コモン直近に追加**（SPEC §5.4 の「100nF ＋ 1µF」と整合）。C12 は予備 100nF のまま | 2026-09-20 |
| TESTEN / SHIELD | **U1 TESTEN(19) → GND、J1 SHIELD → GND 直結**（§4.1） | 2026-09-20 |
| LCSC のフィールド名 | **`LCSC Part #`** に統一（§2.1） | 2026-09-20 |
| 回路図レビュー（`hardware/out/review/REVIEW.md`）への対応 | **回路図・PCB・BOM は変更しない。** ① 標準ファーム = `pico_dig26.uf2`。`pico_baseline.uf2` は GP0 を UART TX 出力にして CH0 と衝突するので使用禁止（SPEC §2.3）② C26 = 10µF セラミック（C15850）のまま発注し、実機で 3V3 レールを観測（SPEC §4.4・§11 #5a）③ SW1 は J3 を外してから切り替える運用（SPEC §6.1・本書 §1.2.3）④ dgatf の GP18 = デバッグ／GP19 = レベルトリガに記載修正（SPEC §7）。回答は `hardware/out/review/RESPONSE.md` | 2026-09-20 |
