ramtuc/rp2040-logic-analyzer/hardware/out/netlist-check.md

| ネット | 判定 | 期待ノード数 | 実ノード数 | 備考 |
|:---|:---|--:|--:|:---|
| `/CH0_IN` | OK | 2 | 2 |  |
| `/CH0_A` | OK | 2 | 2 |  |
| `/D0` | OK | 2 | 2 |  |
| `/CH1_IN` | OK | 2 | 2 |  |
| `/CH1_A` | OK | 2 | 2 |  |
| `/D1` | OK | 2 | 2 |  |
| `/CH2_IN` | OK | 2 | 2 |  |
| `/CH2_A` | OK | 2 | 2 |  |
| `/D2` | OK | 2 | 2 |  |
| `/CH3_IN` | OK | 2 | 2 |  |
| `/CH3_A` | OK | 2 | 2 |  |
| `/D3` | OK | 2 | 2 |  |
| `/CH4_IN` | OK | 2 | 2 |  |
| `/CH4_A` | OK | 2 | 2 |  |
| `/D4` | OK | 2 | 2 |  |
| `/CH5_IN` | OK | 2 | 2 |  |
| `/CH5_A` | OK | 2 | 2 |  |
| `/D5` | OK | 2 | 2 |  |
| `/CH6_IN` | OK | 2 | 2 |  |
| `/CH6_A` | OK | 2 | 2 |  |
| `/D6` | OK | 2 | 2 |  |
| `/CH7_IN` | OK | 2 | 2 |  |
| `/CH7_A` | OK | 2 | 2 |  |
| `/D7` | OK | 2 | 2 |  |
| `/CH8_IN` | OK | 2 | 2 |  |
| `/CH8_A` | OK | 2 | 2 |  |
| `/D8` | OK | 2 | 2 |  |
| `/CH9_IN` | OK | 2 | 2 |  |
| `/CH9_A` | OK | 2 | 2 |  |
| `/D9` | OK | 2 | 2 |  |
| `/CH10_IN` | OK | 2 | 2 |  |
| `/CH10_A` | OK | 2 | 2 |  |
| `/D10` | OK | 2 | 2 |  |
| `/CH11_IN` | OK | 2 | 2 |  |
| `/CH11_A` | OK | 2 | 2 |  |
| `/D11` | OK | 2 | 2 |  |
| `/CH12_IN` | OK | 2 | 2 |  |
| `/CH12_A` | OK | 2 | 2 |  |
| `/D12` | OK | 2 | 2 |  |
| `/CH13_IN` | OK | 2 | 2 |  |
| `/CH13_A` | OK | 2 | 2 |  |
| `/D13` | OK | 2 | 2 |  |
| `/CH14_IN` | OK | 2 | 2 |  |
| `/CH14_A` | OK | 2 | 2 |  |
| `/D14` | OK | 2 | 2 |  |
| `/CH15_IN` | OK | 2 | 2 |  |
| `/CH15_A` | OK | 2 | 2 |  |
| `/D15` | OK | 2 | 2 |  |
| `+5V` | OK | 8 | 8 |  |
| `+3V3` | OK | 35 | 35 |  |
| `VREF` | OK | 11 | 11 |  |
| `/DVDD` | OK | 6 | 6 |  |
| `/USB_DP` | OK | 5 | 5 |  |
| `/USB_DP_MCU` | OK | 2 | 2 |  |
| `/USB_DM` | OK | 5 | 5 |  |
| `/USB_DM_MCU` | OK | 2 | 2 |  |
| `/CC1` | OK | 2 | 2 |  |
| `/CC2` | OK | 2 | 2 |  |
| `/XIN` | OK | 3 | 3 |  |
| `/XOUT` | OK | 2 | 2 |  |
| `/XTAL_DRV` | OK | 3 | 3 |  |
| `/QSPI_SS_N` | OK | 4 | 4 |  |
| `/QSPI_SCLK` | OK | 2 | 2 |  |
| `/QSPI_SD0` | OK | 2 | 2 |  |
| `/QSPI_SD1` | OK | 2 | 2 |  |
| `/QSPI_SD2` | OK | 2 | 2 |  |
| `/QSPI_SD3` | OK | 2 | 2 |  |
| `/USB_BOOT` | OK | 3 | 3 |  |
| `/RUN` | OK | 3 | 3 |  |
| `/TXU_OE` | OK | 6 | 6 |  |
| `/LED_STATUS` | OK | 2 | 2 |  |
| `/GP16` | OK | 2 | 2 |  |
| `/GP17` | OK | 2 | 2 |  |
| `/GP18` | OK | 2 | 2 |  |
| `/GP19` | OK | 2 | 2 |  |
| `/GP20` | OK | 2 | 2 |  |
| `/GP21` | OK | 2 | 2 |  |
| `/GP22` | OK | 2 | 2 |  |
| `/GP26_ADC0` | OK | 2 | 2 |  |
| `/GP27_ADC1` | OK | 2 | 2 |  |
| `/GP28_ADC2` | OK | 2 | 2 |  |
| `/VREF_EXT` | OK | 2 | 2 |  |
| `/SWCLK` | OK | 2 | 2 |  |
| `/SWDIO` | OK | 2 | 2 |  |
| `GND` | OK | 70 | 70 |  |
| `Net-(D1-A)` | OK | 2 | 2 |  |
| `Net-(D2-A)` | OK | 2 | 2 |  |
| `Net-(D3-A)` | OK | 2 | 2 |  |

期待ネット 88 / 実ネット 102 / NG 0 / 期待表に無いネット 0: []
no_connect による unconnected ネット 14: `unconnected-(J1-SBU1-PadA8)`, `unconnected-(J1-SBU2-PadB8)`, `unconnected-(SW1-MNT-Pad5)`, `unconnected-(SW1-MNT-Pad6)`, `unconnected-(U1-GPIO24-Pad36)`, `unconnected-(U1-GPIO29{slash}ADC3-Pad41)`, `unconnected-(U3-NC-Pad6)`, `unconnected-(U3-NC-Pad9)`, `unconnected-(U4-NC-Pad6)`, `unconnected-(U4-NC-Pad9)`, `unconnected-(U5-NC-Pad6)`, `unconnected-(U5-NC-Pad9)`, `unconnected-(U6-NC-Pad6)`, `unconnected-(U6-NC-Pad9)`
