ramtuc/rp2040-logic-analyzer/hardware/out/a1/render-bottom.png

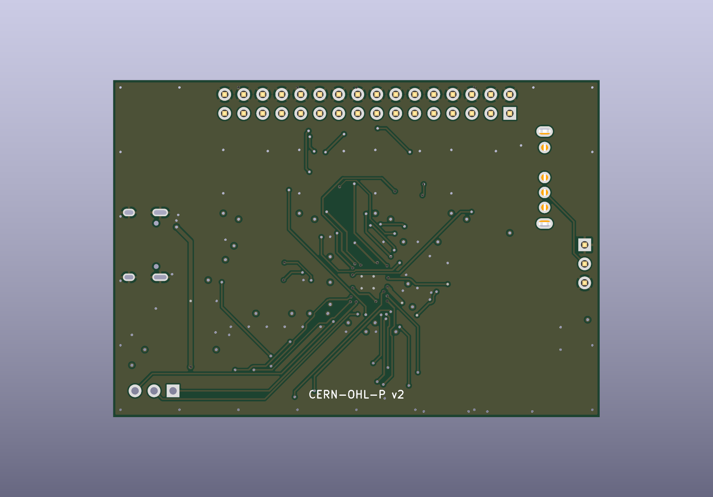
hardware/out/a1/render-bottom.png
