ramtuc/rp2040-logic-analyzer/hardware/out/a1/render-top.png

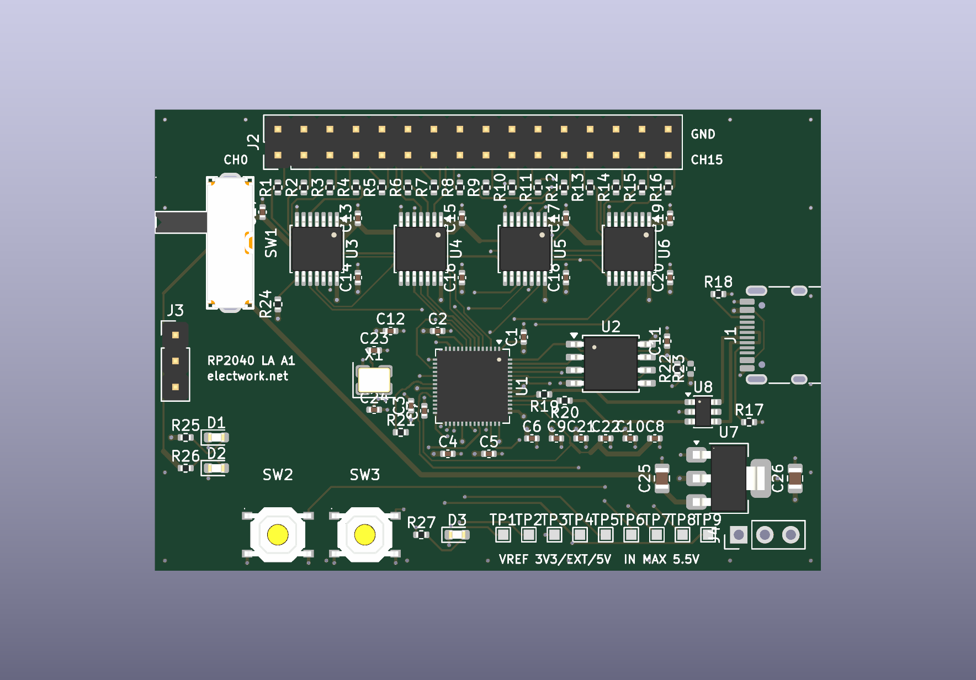
hardware/out/a1/render-top.png
