ramtuc/rp2040-logic-analyzer/hardware/out/completion/finished-preview.png

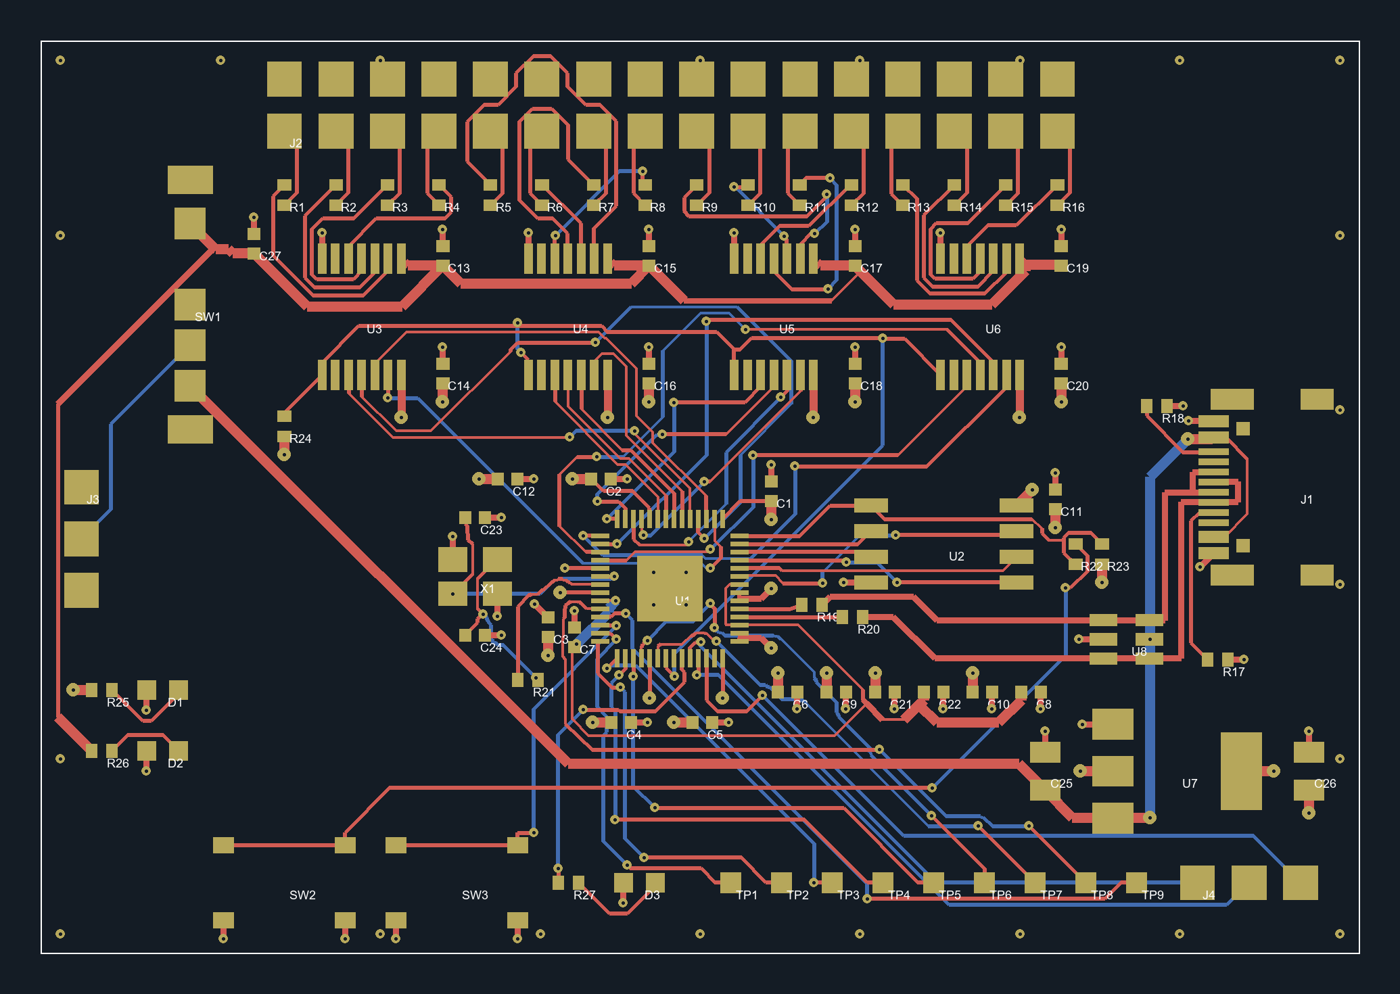
hardware/out/completion/finished-preview.png
