ramtuc/rp2040-logic-analyzer/hardware/out/completion/overview-before.png

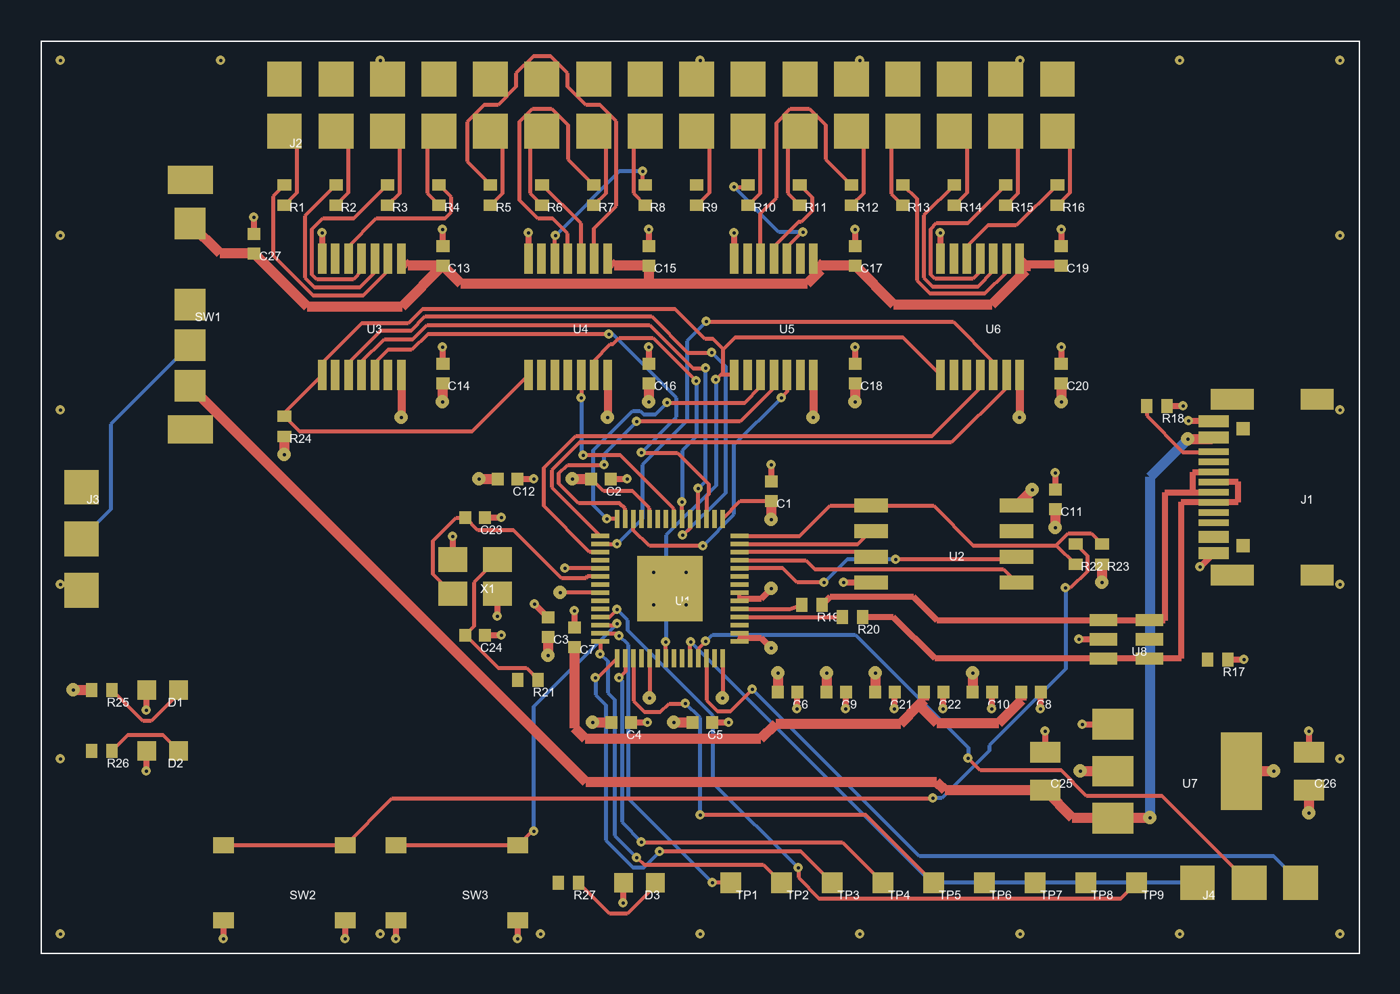
hardware/out/completion/overview-before.png
