ramtuc/rp2040-logic-analyzer/hardware/out/route/render-top.png

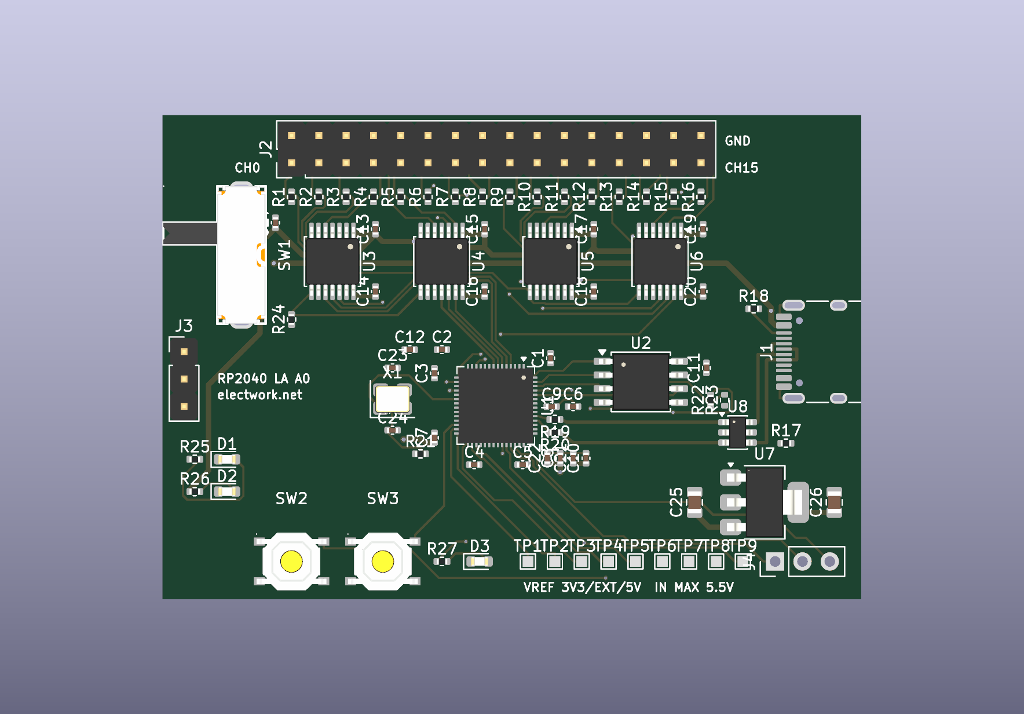
hardware/out/route/render-top.png
