ramtuc/rp2040-logic-analyzer/hardware/out/a1/bom-cpl-check.md

# BOM / CPL 照合（回路図の全参照子 → JLCPCB BOM・CPL・THT・DNP・TP）

- 回路図の部品: **82**（bom-flat.csv）／基板のフットプリント: **82**
- CPL（SMD 実装対象）: **68**／JLCPCB BOM の参照子: **69**（行数 19・全行に JLCPCB Part # あり: はい）

| Ref | Comment | 区分（基板 attr） | BOM | CPL | JLCPCB Part # |
|:--|:--|:--|:--|:--|:--|
| C1 | 100nF | SMD 実装 | ○ | ○ | C1525 |
| C2 | 100nF | SMD 実装 | ○ | ○ | C1525 |
| C3 | 100nF | SMD 実装 | ○ | ○ | C1525 |
| C4 | 100nF | SMD 実装 | ○ | ○ | C1525 |
| C5 | 100nF | SMD 実装 | ○ | ○ | C1525 |
| C6 | 100nF | SMD 実装 | ○ | ○ | C1525 |
| C7 | 100nF | SMD 実装 | ○ | ○ | C1525 |
| C8 | 100nF | SMD 実装 | ○ | ○ | C1525 |
| C9 | 100nF | SMD 実装 | ○ | ○ | C1525 |
| C10 | 100nF | SMD 実装 | ○ | ○ | C1525 |
| C11 | 100nF | SMD 実装 | ○ | ○ | C1525 |
| C12 | 100nF | SMD 実装 | ○ | ○ | C1525 |
| C13 | 100nF | SMD 実装 | ○ | ○ | C1525 |
| C14 | 100nF | SMD 実装 | ○ | ○ | C1525 |
| C15 | 100nF | SMD 実装 | ○ | ○ | C1525 |
| C16 | 100nF | SMD 実装 | ○ | ○ | C1525 |
| C17 | 100nF | SMD 実装 | ○ | ○ | C1525 |
| C18 | 100nF | SMD 実装 | ○ | ○ | C1525 |
| C19 | 100nF | SMD 実装 | ○ | ○ | C1525 |
| C20 | 100nF | SMD 実装 | ○ | ○ | C1525 |
| C21 | 1µF | SMD 実装 | ○ | ○ | C52923 |
| C22 | 1µF | SMD 実装 | ○ | ○ | C52923 |
| C23 | 15pF | SMD 実装 | ○ | ○ | C1548 |
| C24 | 15pF | SMD 実装 | ○ | ○ | C1548 |
| C25 | 10µF | SMD 実装 | ○ | ○ | C15850 |
| C26 | 10µF | SMD 実装 | ○ | ○ | C15850 |
| C27 | 1µF | SMD 実装 | ○ | ○ | C52923 |
| D1 | LED RED | SMD 実装 | ○ | ○ | C2286 |
| D2 | LED RED | SMD 実装 | ○ | ○ | C2286 |
| D3 | LED RED | SMD 実装 | ○ | ○ | C2286 |
| J1 | TYPE-C-31-M-12 | SMD 実装 | ○ | ○ | C165948 |
| J2 | PROBE 2x16 | THT（手はんだ） | — | — |  |
| J3 | VREF_EXT | THT（手はんだ） | — | — |  |
| J4 | ADC 1x3 (DNF) | DNP（未実装） | — | — |  |
| R1 | 100Ω | SMD 実装 | ○ | ○ | C25076 |
| R2 | 100Ω | SMD 実装 | ○ | ○ | C25076 |
| R3 | 100Ω | SMD 実装 | ○ | ○ | C25076 |
| R4 | 100Ω | SMD 実装 | ○ | ○ | C25076 |
| R5 | 100Ω | SMD 実装 | ○ | ○ | C25076 |
| R6 | 100Ω | SMD 実装 | ○ | ○ | C25076 |
| R7 | 100Ω | SMD 実装 | ○ | ○ | C25076 |
| R8 | 100Ω | SMD 実装 | ○ | ○ | C25076 |
| R9 | 100Ω | SMD 実装 | ○ | ○ | C25076 |
| R10 | 100Ω | SMD 実装 | ○ | ○ | C25076 |
| R11 | 100Ω | SMD 実装 | ○ | ○ | C25076 |
| R12 | 100Ω | SMD 実装 | ○ | ○ | C25076 |
| R13 | 100Ω | SMD 実装 | ○ | ○ | C25076 |
| R14 | 100Ω | SMD 実装 | ○ | ○ | C25076 |
| R15 | 100Ω | SMD 実装 | ○ | ○ | C25076 |
| R16 | 100Ω | SMD 実装 | ○ | ○ | C25076 |
| R17 | 5.1kΩ | SMD 実装 | ○ | ○ | C25905 |
| R18 | 5.1kΩ | SMD 実装 | ○ | ○ | C25905 |
| R19 | 27Ω | SMD 実装 | ○ | ○ | C25100 |
| R20 | 27Ω | SMD 実装 | ○ | ○ | C25100 |
| R21 | 1kΩ | SMD 実装 | ○ | ○ | C11702 |
| R22 | 1kΩ | SMD 実装 | ○ | ○ | C11702 |
| R23 | 10kΩ | DNP（未実装） | — | — |  |
| R24 | 10kΩ | SMD 実装 | ○ | ○ | C25744 |
| R25 | 1kΩ | SMD 実装 | ○ | ○ | C11702 |
| R26 | 1kΩ | SMD 実装 | ○ | ○ | C11702 |
| R27 | 1kΩ | SMD 実装 | ○ | ○ | C11702 |
| SW1 | SK13D07VG5 | THT（手はんだ） | ○ | — | C393948 |
| SW2 | TS-1187A-B-A-B | SMD 実装 | ○ | ○ | C318884 |
| SW3 | TS-1187A-B-A-B | SMD 実装 | ○ | ○ | C318884 |
| TP1 | GP16 | テストパッド | — | — |  |
| TP2 | GP17 | テストパッド | — | — |  |
| TP3 | GP18 | テストパッド | — | — |  |
| TP4 | GP19 | テストパッド | — | — |  |
| TP5 | GP20 | テストパッド | — | — |  |
| TP6 | GP21 | テストパッド | — | — |  |
| TP7 | GP22 | テストパッド | — | — |  |
| TP8 | SWCLK | テストパッド | — | — |  |
| TP9 | SWDIO | テストパッド | — | — |  |
| U1 | RP2040 | SMD 実装 | ○ | ○ | C2040 |
| U2 | W25Q128JVSIQ | SMD 実装 | ○ | ○ | C97521 |
| U3 | TXU0104PWR | SMD 実装 | ○ | ○ | C2938871 |
| U4 | TXU0104PWR | SMD 実装 | ○ | ○ | C2938871 |
| U5 | TXU0104PWR | SMD 実装 | ○ | ○ | C2938871 |
| U6 | TXU0104PWR | SMD 実装 | ○ | ○ | C2938871 |
| U7 | AMS1117-3.3 | SMD 実装 | ○ | ○ | C6186 |
| U8 | USBLC6-2SC6 | SMD 実装 | ○ | ○ | C7519 |
| X1 | ABM8-272-T3 12MHz | SMD 実装 | ○ | ○ | C20625731 |

## 集計

- 回路図 82 ＝ CPL 68 ＋ THT 3（J2, J3, SW1） ＋ DNP 2（J4, R23）＋ TP 9 → 82
- JLCPCB BOM 69 ＝ CPL 68 ＋ CPL に無い BOM 行 ['SW1']（THT・JLCPCB 側で未実装扱い）
- BOM から落とした参照子（LCSC 無し）: J2（PROBE 2x16）, J3（VREF_EXT）, TP1（GP16）, TP2（GP17）, TP3（GP18）, TP4（GP19）, TP5（GP20）, TP6（GP21）, TP7（GP22）, TP8（SWCLK）, TP9（SWDIO）
- **不整合: 0 件**
