ramtuc/rp2040-logic-analyzer/hardware/out/bom-grouped.csv

Designator | Comment | Footprint | LCSC Part # | Qty | DNP
C1,C2,C3,C4,C5,C6,C7,C8,C9,C10,C11,C12,C13,C14,C15,C16,C17,C18,C19,C20 | 100nF | Capacitor_SMD:C_0402_1005Metric |  | 20
C21,C22,C27 | 1µF | Capacitor_SMD:C_0402_1005Metric |  | 3
C23,C24 | 15pF | Capacitor_SMD:C_0402_1005Metric |  | 2
C25,C26 | 10µF | Capacitor_SMD:C_0805_2012Metric |  | 2
D1,D2,D3 | LED RED | LED_SMD:LED_0603_1608Metric | C2286 | 3
J1 | TYPE-C-31-M-12 | Connector_USB:USB_C_Receptacle_HRO_TYPE-C-31-M-12 | C165948 | 1
J2 | PROBE 2x16 | Connector_PinHeader_2.54mm:PinHeader_2x16_P2.54mm_Vertical |  | 1
J3 | VREF_EXT | Connector_PinHeader_2.54mm:PinHeader_1x03_P2.54mm_Vertical |  | 1
J4 | ADC 1x3 (DNF) | Connector_PinHeader_2.54mm:PinHeader_1x03_P2.54mm_Vertical |  | 1 | 未実装(DNP)
R1,R2,R3,R4,R5,R6,R7,R8,R9,R10,R11,R12,R13,R14,R15,R16 | 100Ω | Resistor_SMD:R_0402_1005Metric |  | 16
R17,R18 | 5.1kΩ | Resistor_SMD:R_0402_1005Metric |  | 2
R19,R20 | 27Ω | Resistor_SMD:R_0402_1005Metric |  | 2
R21,R22,R25,R26,R27 | 1kΩ | Resistor_SMD:R_0402_1005Metric |  | 5
R23 | 10kΩ | Resistor_SMD:R_0402_1005Metric |  | 1 | 未実装(DNP)
R24 | 10kΩ | Resistor_SMD:R_0402_1005Metric |  | 1
SW1 | SK13D07VG5 | lcsc:SW-TH_SK13D07VG5 | C393948 | 1
SW2,SW3 | TS-1187A-B-A-B | lcsc:SW-SMD_4P-L5.1-W5.1-P3.70-LS6.5-TL_H1.5 | C318884 | 2
TP1 | GP16 | TestPoint:TestPoint_Pad_1.0x1.0mm |  | 1
TP2 | GP17 | TestPoint:TestPoint_Pad_1.0x1.0mm |  | 1
TP3 | GP18 | TestPoint:TestPoint_Pad_1.0x1.0mm |  | 1
TP4 | GP19 | TestPoint:TestPoint_Pad_1.0x1.0mm |  | 1
TP5 | GP20 | TestPoint:TestPoint_Pad_1.0x1.0mm |  | 1
TP6 | GP21 | TestPoint:TestPoint_Pad_1.0x1.0mm |  | 1
TP7 | GP22 | TestPoint:TestPoint_Pad_1.0x1.0mm |  | 1
TP8 | SWCLK | TestPoint:TestPoint_Pad_1.0x1.0mm |  | 1
TP9 | SWDIO | TestPoint:TestPoint_Pad_1.0x1.0mm |  | 1
U1 | RP2040 | Package_DFN_QFN:QFN-56-1EP_7x7mm_P0.4mm_EP3.2x3.2mm | C2040 | 1
U2 | W25Q128JVSIQ | Package_SO:SOIC-8_5.3x5.3mm_P1.27mm | C97521 | 1
U3,U4,U5,U6 | TXU0104PWR | Package_SO:TSSOP-14_4.4x5mm_P0.65mm | C2938871 | 4
U7 | AMS1117-3.3 | Package_TO_SOT_SMD:SOT-223-3_TabPin2 | C6186 | 1
U8 | USBLC6-2SC6 | Package_TO_SOT_SMD:SOT-23-6 | C7519 | 1
X1 | ABM8-272-T3 12MHz | Crystal:Crystal_SMD_3225-4Pin_3.2x2.5mm | C20625731 | 1
