ramtuc/rp2040-logic-analyzer/hardware/out/bom-flat.csv

Designator | Comment | Footprint | LCSC Part # | DNP | Description
C1 | 100nF | Capacitor_SMD:C_0402_1005Metric |  |  | 100nF X7R 16V 0402, RP2040 IOVDD pin 1 (KIT §5-1)
C2 | 100nF | Capacitor_SMD:C_0402_1005Metric |  |  | 100nF X7R 16V 0402, RP2040 IOVDD pin 10 (KIT §5-1)
C3 | 100nF | Capacitor_SMD:C_0402_1005Metric |  |  | 100nF X7R 16V 0402, RP2040 IOVDD pin 22 (KIT §5-1)
C4 | 100nF | Capacitor_SMD:C_0402_1005Metric |  |  | 100nF X7R 16V 0402, RP2040 IOVDD pin 33 (KIT §5-1)
C5 | 100nF | Capacitor_SMD:C_0402_1005Metric |  |  | 100nF X7R 16V 0402, RP2040 IOVDD pin 42 (KIT §5-1)
C6 | 100nF | Capacitor_SMD:C_0402_1005Metric |  |  | 100nF X7R 16V 0402, RP2040 IOVDD pin 49 (KIT §5-1)
C7 | 100nF | Capacitor_SMD:C_0402_1005Metric |  |  | 100nF X7R 16V 0402, RP2040 DVDD pin 23 (KIT §5-1)
C8 | 100nF | Capacitor_SMD:C_0402_1005Metric |  |  | 100nF X7R 16V 0402, RP2040 DVDD pin 50 (KIT §5-1)
C9 | 100nF | Capacitor_SMD:C_0402_1005Metric |  |  | 100nF X7R 16V 0402, RP2040 USB_VDD pin 48 (KIT §5-1)
C10 | 100nF | Capacitor_SMD:C_0402_1005Metric |  |  | 100nF X7R 16V 0402, RP2040 ADC_AVDD pin 43 (KIT §5-1)
C11 | 100nF | Capacitor_SMD:C_0402_1005Metric |  |  | 100nF X7R 16V 0402, U2 flash VCC - place at U2 pin 8 (KIT §5-1)
C12 | 100nF | Capacitor_SMD:C_0402_1005Metric |  |  | 100nF X7R 16V 0402, spare (SPEC §10 #22 予備)
C13 | 100nF | Capacitor_SMD:C_0402_1005Metric |  |  | 100nF X7R 16V 0402, U3 VCCA (KIT §5-11)
C14 | 100nF | Capacitor_SMD:C_0402_1005Metric |  |  | 100nF X7R 16V 0402, U3 VCCB (KIT §5-11)
C15 | 100nF | Capacitor_SMD:C_0402_1005Metric |  |  | 100nF X7R 16V 0402, U4 VCCA (KIT §5-11)
C16 | 100nF | Capacitor_SMD:C_0402_1005Metric |  |  | 100nF X7R 16V 0402, U4 VCCB (KIT §5-11)
C17 | 100nF | Capacitor_SMD:C_0402_1005Metric |  |  | 100nF X7R 16V 0402, U5 VCCA (KIT §5-11)
C18 | 100nF | Capacitor_SMD:C_0402_1005Metric |  |  | 100nF X7R 16V 0402, U5 VCCB (KIT §5-11)
C19 | 100nF | Capacitor_SMD:C_0402_1005Metric |  |  | 100nF X7R 16V 0402, U6 VCCA (KIT §5-11)
C20 | 100nF | Capacitor_SMD:C_0402_1005Metric |  |  | 100nF X7R 16V 0402, U6 VCCB (KIT §5-11)
C21 | 1µF | Capacitor_SMD:C_0402_1005Metric |  |  | 1µF X5R 0402, RP2040 VREG_VIN pin 44 (KIT §5-2, 公式指定)
C22 | 1µF | Capacitor_SMD:C_0402_1005Metric |  |  | 1µF X5R 0402, RP2040 VREG_VOUT pin 45 (KIT §5-2, 公式指定)
C23 | 15pF | Capacitor_SMD:C_0402_1005Metric |  |  | 15pF NP0 0402 crystal load, XIN side (KIT §5-3)
C24 | 15pF | Capacitor_SMD:C_0402_1005Metric |  |  | 15pF NP0 0402 crystal load, XOUT/XTAL_DRV side (KIT §5-3)
C25 | 10µF | Capacitor_SMD:C_0805_2012Metric |  |  | 10µF X5R 16V 0805 LDO input (SPEC §10 #26)
C26 | 10µF | Capacitor_SMD:C_0805_2012Metric |  |  | 10µF X5R 16V 0805 LDO output (SPEC §10 #26)
C27 | 1µF | Capacitor_SMD:C_0402_1005Metric |  |  | 1µF X5R 0402, VREF bulk next to SW1 common (SPEC §5.4, Manager 2026-09-20)
D1 | LED RED | LED_SMD:LED_0603_1608Metric | C2286 |  | LED red 0603, +3V3 power indicator (SPEC §6 D1)
D2 | LED RED | LED_SMD:LED_0603_1608Metric | C2286 |  | LED red 0603, VREF indicator: dark when SW1 is not set (SPEC §6 D2)
D3 | LED RED | LED_SMD:LED_0603_1608Metric | C2286 |  | LED red 0603, status on GP25 (SPEC §6 D3)
J1 | TYPE-C-31-M-12 | Connector_USB:USB_C_Receptacle_HRO_TYPE-C-31-M-12 | C165948 |  | USB-C receptacle 16P, USB 2.0 (SPEC §10 #7, HRO TYPE-C-31-M-12)
J2 | PROBE 2x16 | Connector_PinHeader_2.54mm:PinHeader_2x16_P2.54mm_Vertical |  |  | Pin header 2x16 2.54mm probe header: odd row = CH0..CH15, even row = GND (SPEC §6 J2)
J3 | VREF_EXT | Connector_PinHeader_2.54mm:PinHeader_1x03_P2.54mm_Vertical |  |  | Pin header 1x3 2.54mm, VREF EXT input (SPEC §6: EXT + GND x2). Pin 2 = EXT, pins 1/3 = GND
J4 | ADC 1x3 (DNF) | Connector_PinHeader_2.54mm:PinHeader_1x03_P2.54mm_Vertical |  | 未実装(DNP) | Pin header 1x3 2.54mm, GP26/27/28 analog, DNF (SPEC §6 J4)
R1 | 100Ω | Resistor_SMD:R_0402_1005Metric |  |  | 100Ω 1% 0402 input series CH0 (SPEC §5.3 / KIT §5-13)
R2 | 100Ω | Resistor_SMD:R_0402_1005Metric |  |  | 100Ω 1% 0402 input series CH1 (SPEC §5.3 / KIT §5-13)
R3 | 100Ω | Resistor_SMD:R_0402_1005Metric |  |  | 100Ω 1% 0402 input series CH2 (SPEC §5.3 / KIT §5-13)
R4 | 100Ω | Resistor_SMD:R_0402_1005Metric |  |  | 100Ω 1% 0402 input series CH3 (SPEC §5.3 / KIT §5-13)
R5 | 100Ω | Resistor_SMD:R_0402_1005Metric |  |  | 100Ω 1% 0402 input series CH4 (SPEC §5.3 / KIT §5-13)
R6 | 100Ω | Resistor_SMD:R_0402_1005Metric |  |  | 100Ω 1% 0402 input series CH5 (SPEC §5.3 / KIT §5-13)
R7 | 100Ω | Resistor_SMD:R_0402_1005Metric |  |  | 100Ω 1% 0402 input series CH6 (SPEC §5.3 / KIT §5-13)
R8 | 100Ω | Resistor_SMD:R_0402_1005Metric |  |  | 100Ω 1% 0402 input series CH7 (SPEC §5.3 / KIT §5-13)
R9 | 100Ω | Resistor_SMD:R_0402_1005Metric |  |  | 100Ω 1% 0402 input series CH8 (SPEC §5.3 / KIT §5-13)
R10 | 100Ω | Resistor_SMD:R_0402_1005Metric |  |  | 100Ω 1% 0402 input series CH9 (SPEC §5.3 / KIT §5-13)
R11 | 100Ω | Resistor_SMD:R_0402_1005Metric |  |  | 100Ω 1% 0402 input series CH10 (SPEC §5.3 / KIT §5-13)
R12 | 100Ω | Resistor_SMD:R_0402_1005Metric |  |  | 100Ω 1% 0402 input series CH11 (SPEC §5.3 / KIT §5-13)
R13 | 100Ω | Resistor_SMD:R_0402_1005Metric |  |  | 100Ω 1% 0402 input series CH12 (SPEC §5.3 / KIT §5-13)
R14 | 100Ω | Resistor_SMD:R_0402_1005Metric |  |  | 100Ω 1% 0402 input series CH13 (SPEC §5.3 / KIT §5-13)
R15 | 100Ω | Resistor_SMD:R_0402_1005Metric |  |  | 100Ω 1% 0402 input series CH14 (SPEC §5.3 / KIT §5-13)
R16 | 100Ω | Resistor_SMD:R_0402_1005Metric |  |  | 100Ω 1% 0402 input series CH15 (SPEC §5.3 / KIT §5-13)
R17 | 5.1kΩ | Resistor_SMD:R_0402_1005Metric |  |  | 5.1kΩ 1% 0402 USB-C CC pull-down (SPEC §10 #15)
R18 | 5.1kΩ | Resistor_SMD:R_0402_1005Metric |  |  | 5.1kΩ 1% 0402 USB-C CC pull-down (SPEC §10 #15)
R19 | 27Ω | Resistor_SMD:R_0402_1005Metric |  |  | 27Ω 1% 0402 USB D+ series termination, place next to RP2040 (SPEC §10 #16)
R20 | 27Ω | Resistor_SMD:R_0402_1005Metric |  |  | 27Ω 1% 0402 USB D- series termination, place next to RP2040 (SPEC §10 #16)
R21 | 1kΩ | Resistor_SMD:R_0402_1005Metric |  |  | 1kΩ 0402 crystal damping, XOUT side (SPEC §4.3 / KIT §5-4)
R22 | 1kΩ | Resistor_SMD:R_0402_1005Metric |  |  | 1kΩ 0402 BOOTSEL series (SPEC §4.2 / KIT §5-6)
R23 | 10kΩ | Resistor_SMD:R_0402_1005Metric |  | 未実装(DNP) | 10kΩ 0402 QSPI_SS pull-up, DNF (SPEC §4.2 / KIT §5-5)
R24 | 10kΩ | Resistor_SMD:R_0402_1005Metric |  |  | 10kΩ 0402 TXU0104 OE pull-up to +3V3 (SPEC §5.3 / KIT §5-10)
R25 | 1kΩ | Resistor_SMD:R_0402_1005Metric |  |  | 1kΩ 0402 LED current limit (SPEC §10 #21)
R26 | 1kΩ | Resistor_SMD:R_0402_1005Metric |  |  | 1kΩ 0402 LED current limit (SPEC §10 #21)
R27 | 1kΩ | Resistor_SMD:R_0402_1005Metric |  |  | 1kΩ 0402 LED current limit (SPEC §10 #21)
SW1 | SK13D07VG5 | lcsc:SW-TH_SK13D07VG5 | C393948 |  | SP3T slide switch, THT right-angle, SHORTING type. Contact order +3V3 / EXT / +5V so +3V3 and +5V never bridge (SPEC §5.4, KIT §1.2.3)
SW2 | TS-1187A-B-A-B | lcsc:SW-SMD_4P-L5.1-W5.1-P3.70-LS6.5-TL_H1.5 | C318884 |  | Tactile switch, BOOTSEL: pulls QSPI_SS low via R22 (SPEC §6 SW2)
SW3 | TS-1187A-B-A-B | lcsc:SW-SMD_4P-L5.1-W5.1-P3.70-LS6.5-TL_H1.5 | C318884 |  | Tactile switch, RESET: pulls RUN low, no external parts (SPEC §6 SW3, KIT §5 RUN)
TP1 | GP16 | TestPoint:TestPoint_Pad_1.0x1.0mm |  |  | Test pad 1.0mm, GP16 (SPEC §6 J5 test pads for dgatf UART/config)
TP2 | GP17 | TestPoint:TestPoint_Pad_1.0x1.0mm |  |  | Test pad 1.0mm, GP17 (SPEC §6 J5 test pads for dgatf UART/config)
TP3 | GP18 | TestPoint:TestPoint_Pad_1.0x1.0mm |  |  | Test pad 1.0mm, GP18 (SPEC §6 J5 test pads for dgatf UART/config)
TP4 | GP19 | TestPoint:TestPoint_Pad_1.0x1.0mm |  |  | Test pad 1.0mm, GP19 (SPEC §6 J5 test pads for dgatf UART/config)
TP5 | GP20 | TestPoint:TestPoint_Pad_1.0x1.0mm |  |  | Test pad 1.0mm, GP20 (SPEC §6 J5 test pads for dgatf UART/config)
TP6 | GP21 | TestPoint:TestPoint_Pad_1.0x1.0mm |  |  | Test pad 1.0mm, GP21 (SPEC §6 J5 test pads for dgatf UART/config)
TP7 | GP22 | TestPoint:TestPoint_Pad_1.0x1.0mm |  |  | Test pad 1.0mm, GP22 (SPEC §6 J5 test pads for dgatf UART/config)
TP8 | SWCLK | TestPoint:TestPoint_Pad_1.0x1.0mm |  |  | Test pad 1.0mm, SWCLK (KIT §5-15: SWD brought out, Manager 2026-09-20)
TP9 | SWDIO | TestPoint:TestPoint_Pad_1.0x1.0mm |  |  | Test pad 1.0mm, SWDIO (KIT §5-15: SWD brought out, Manager 2026-09-20)
U1 | RP2040 | Package_DFN_QFN:QFN-56-1EP_7x7mm_P0.4mm_EP3.2x3.2mm | C2040 |  | Raspberry Pi RP2040, QFN-56 7x7mm (SPEC §10 #1)
U2 | W25Q128JVSIQ | Package_SO:SOIC-8_5.3x5.3mm_P1.27mm | C97521 |  | 128Mbit QSPI flash, SOIC-8 208mil (SPEC §10 #2)
U3 | TXU0104PWR | Package_SO:TSSOP-14_4.4x5mm_P0.65mm | C2938871 |  | 4-bit level translator A->B, Schmitt inputs, CH0-CH3 (SPEC §10 #3)
U4 | TXU0104PWR | Package_SO:TSSOP-14_4.4x5mm_P0.65mm | C2938871 |  | 4-bit level translator A->B, Schmitt inputs, CH4-CH7 (SPEC §10 #3)
U5 | TXU0104PWR | Package_SO:TSSOP-14_4.4x5mm_P0.65mm | C2938871 |  | 4-bit level translator A->B, Schmitt inputs, CH8-CH11 (SPEC §10 #3)
U6 | TXU0104PWR | Package_SO:TSSOP-14_4.4x5mm_P0.65mm | C2938871 |  | 4-bit level translator A->B, Schmitt inputs, CH12-CH15 (SPEC §10 #3)
U7 | AMS1117-3.3 | Package_TO_SOT_SMD:SOT-223-3_TabPin2 | C6186 |  | LDO 3.3V 1A SOT-223 (SPEC §10 #4)
U8 | USBLC6-2SC6 | Package_TO_SOT_SMD:SOT-23-6 | C7519 |  | USB 2.0 ESD protection, SOT-23-6 (SPEC §10 #5)
X1 | ABM8-272-T3 12MHz | Crystal:Crystal_SMD_3225-4Pin_3.2x2.5mm | C20625731 |  | Crystal 12MHz 3225 4-pin, CL 10pF, ESR <= 50Ω (SPEC §4.3, Raspberry Pi 公式推奨品)
