ramtuc/rp2040-logic-analyzer/hardware/out/step3/01-fanout.md

# ファンアウト（GND / +3V3 → 内層ベタ）

- 入力: `rp2040-logic-analyzer.kicad_pcb`
- 既存配線を locked にした本数: 14
- 置いたビア: **79**（GND 48 / +3V3 31）
- 置けなかったパッド: 0

| Ref | Pad | Net | via X | via Y | 径/穴 | スタブ幅 | スタブ長 | 位置の決め方 |
|:--|:--|:--|--:|--:|:--|--:|--:|:--|
| - | - | +3V3 | 136.000 | 127.000 | 0.65/0.35 | 0.00 | 0.00 | dangling end of 0.3-wide track |
| U1 | 44+43 | +3V3 | 136.000 | 129.950 | 0.65/0.35 | 0.30 | 0.71 | merge 44+43 |
| U1 | 22 | +3V3 | 125.600 | 127.200 | 0.65/0.35 | 0.20 | 1.96 | -1+0 gap 1.20 |
| U1 | 33 | +3V3 | 130.000 | 132.400 | 0.65/0.35 | 0.20 | 1.96 | +0+1 gap 1.20 |
| U1 | 42 | +3V3 | 133.600 | 132.400 | 0.65/0.35 | 0.20 | 1.96 | +0+1 gap 1.20 |
| U1 | 19 | GND | 125.850 | 126.000 | 0.45/0.25 | 0.20 | 1.71 | -1+0 gap 1.05 |
| C1 | 1 | +3V3 | 136.000 | 123.585 | 0.65/0.35 | 0.50 | 0.91 | +0+1 gap 0.30 |
| C1 | 2 | GND | 136.000 | 120.915 | 0.45/0.25 | 0.30 | 0.81 | +0-1 gap 0.30 |
| C10 | 1 | +3V3 | 145.920 | 131.165 | 0.65/0.35 | 0.50 | 0.94 | +0-1 gap 0.30 |
| C10 | 2 | GND | 146.880 | 132.935 | 0.45/0.25 | 0.30 | 0.83 | +0+1 gap 0.30 |
| C11 | 1 | +3V3 | 150.000 | 123.985 | 0.65/0.35 | 0.50 | 0.91 | +0+1 gap 0.30 |
| C11 | 2 | GND | 150.000 | 121.315 | 0.45/0.25 | 0.30 | 0.81 | +0-1 gap 0.30 |
| C12 | 1 | +3V3 | 121.615 | 121.600 | 0.65/0.35 | 0.50 | 0.91 | -1+0 gap 0.30 |
| C12 | 2 | GND | 124.285 | 121.600 | 0.45/0.25 | 0.30 | 0.81 | +1+0 gap 0.30 |
| C13 | 2 | GND | 119.810 | 109.315 | 0.45/0.25 | 0.30 | 0.81 | +0-1 gap 0.30 |
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
| U4 | 7 | GND | 124.020 | 109.475 | 0.45/0.25 | 0.30 | 1.26 | +0-1 gap 0.30 |
| U5 | 14 | +3V3 | 138.080 | 118.575 | 0.65/0.35 | 0.40 | 2.11 | +0+1 gap 1.05 |
| U5 | 7 | GND | 134.180 | 109.475 | 0.45/0.25 | 0.30 | 1.26 | +0-1 gap 0.30 |
| U6 | 14 | +3V3 | 148.240 | 118.575 | 0.65/0.35 | 0.40 | 2.11 | +0+1 gap 1.05 |
| U6 | 7 | GND | 144.340 | 109.475 | 0.45/0.25 | 0.30 | 1.26 | +0-1 gap 0.30 |
| U7 | 2 | +3V3 | 151.225 | 136.000 | 0.65/0.35 | 0.50 | 1.62 | -1+0 gap 0.30 |
| U7 | 2 | +3V3 | 160.775 | 136.000 | 0.65/0.35 | 0.50 | 1.62 | +1+0 gap 0.30 |
| U7 | 1 | GND | 151.325 | 133.700 | 0.45/0.25 | 0.30 | 1.52 | -1+0 gap 0.30 |
| U8 | 2 | GND | 151.175 | 129.500 | 0.45/0.25 | 0.30 | 1.19 | -1+0 gap 0.30 |
| X1 | 2 | GND | 122.500 | 128.375 | 0.45/0.25 | 0.30 | 1.12 | +0+1 gap 0.30 |
| X1 | 4 | GND | 120.300 | 124.425 | 0.45/0.25 | 0.30 | 1.12 | +0-1 gap 0.30 |
