ramtuc/rp2040-logic-analyzer/hardware/out/step3/03-final-E-finish.md

# 仕上げ（アーティファクト除去・B.Cu GND ベタ・ビアスティッチ）

- 入力: `02-routed-E.kicad_pcb`
- 消した unlocked segment: 欠片（<0.01 mm）6・同ネットパッド内 48
- B.Cu GND ベタ: 基板全面・クリアランス 0.2・最小幅 0.25・サーマル 0.3/0.3・島は常に除去
- ビアスティッチ（GND 0.45/0.25・外周 1 mm 内側・ピッチ 8 mm）: **24 個**（候補 26・不可 2）
- 配線 552 本 / ビア 155 個

| # | X | Y |
|--:|--:|--:|
| 1 | 100.975 | 100.975 |
| 2 | 108.856 | 100.975 |
| 3 | 116.737 | 100.975 |
| 4 | 132.500 | 100.975 |
| 5 | 140.381 | 100.975 |
| 6 | 148.262 | 100.975 |
| 7 | 156.144 | 100.975 |
| 8 | 164.025 | 100.975 |
| 9 | 164.025 | 109.585 |
| 10 | 164.025 | 118.195 |
| 11 | 164.025 | 126.805 |
| 12 | 164.025 | 135.415 |
| 13 | 164.025 | 144.025 |
| 14 | 156.144 | 144.025 |
| 15 | 148.262 | 144.025 |
| 16 | 140.381 | 144.025 |
| 17 | 132.500 | 144.025 |
| 18 | 124.619 | 144.025 |
| 19 | 116.737 | 144.025 |
| 20 | 100.975 | 144.025 |
| 21 | 100.975 | 135.415 |
| 22 | 100.975 | 126.805 |
| 23 | 100.975 | 118.195 |
| 24 | 100.975 | 109.585 |

打てなかった候補:

- (124.619, 100.975): track/via [/CH4_A] at (124.263, 100.763)
- (108.856, 144.025): hole-to-hole via [GND]
