ramtuc/rp2040-logic-analyzer/hardware/out/step3/render-A-top.png

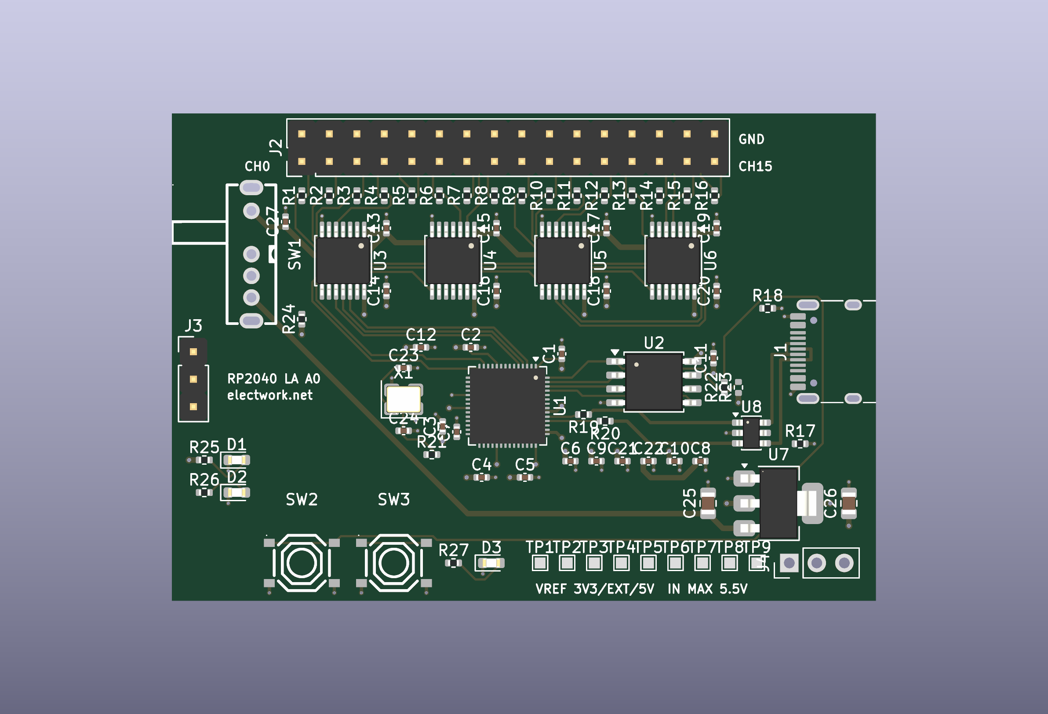
hardware/out/step3/render-A-top.png
