ramtuc/rp2040-logic-analyzer/hardware/out/via-0p3/RESULT.md

# 最小ビア穴径0.3 mmへの変更（2026-09-21）

元のKiCadプロジェクトに反映済みです。

| ビア | 変更前：穴径／外径 | 変更後：穴径／外径 | 個数 |
| --- | --- | --- | --- |
| 小径 | 0.25 / 0.45 mm | 0.30 / 0.45 mm | 148 |
| 大径 | 0.35 / 0.65 mm | 変更なし | 33 |

配線のUUID・位置・幅・層・ネット・ロック状態、ビアの位置・外径、部品位置・パッドのネットをプログラムで比較し、維持されていることを確認しました。ベタは変更後の穴に合わせて再充填しています。回路図は変更していません。

## 設計ルールの変更

- 最小穴径：0.25 → 0.30 mm。
- Default / QSPI / Signal_D / USBの標準ビアとプリセット：外径0.45 / 穴径0.30 mm。
- 最小ビアリング幅：0.10 → 0.075 mm。0.45 mmと0.30 mmの差の半分です。
- ビアの穴から銅までの距離：カスタムルールで0.225 mm。従来の全体設定0.25 mmは残し、ビアを含む組合せだけに適用。
- 銅同士の最小間隔0.15 mm、電源ネットの0.20 mm、穴同士の0.25 mm、DRCの重大度は維持。

穴径だけを大きくした試行では、従来の穴―銅0.25 mmルールで135件の違反が生じました。上記の変更はその事実を隠すものではなく、今回のビア寸法に合わせた製造基準の更新です。JLCPCB公式のビア外径推奨は穴径＋0.15 mm、ビア穴―銅の最小距離は0.20 mmです。採用した0.225 mmは後者に0.025 mmの余裕があります。[JLCPCB製造能力表](https://jlcpcb.com/capabilities/Capab)

新設の `rp2040-logic-analyzer.kicad_dru` はプロジェクトと一緒に保持してください。

## 確認結果

- 元プロジェクトの場所で、ゾーン再充填・保存・回路図比較付きDRCを実行。
- DRCエラー0、未接続0。
- 既存のシルク警告47件、TP1〜TP9のBOM属性差警告9件は継続。
- 出力ドリルファイルの最小工具径0.30 mmを確認。0.25 mmの穴は残っていません。

## 保存先と注意

- 更新先：hardware直下の [rp2040-logic-analyzer.kicad_pcb](../../rp2040-logic-analyzer.kicad_pcb) と同名プロジェクト・カスタムルール。
- 更新版ガーバー＋ドリル：[rp2040-logic-analyzer-via03-gerbers.zip](rp2040-logic-analyzer-via03-gerbers.zip)
- バックアップ：このフォルダ内 `original.kicad_pcb`、`original.kicad_pro`、`original.kicad_sch`。
- 親フォルダ `tools/` の生成スクリプトや `SPEC.md` / `KICAD-KIT.md` は更新していません。再生成すると古い0.25 mm設定へ戻る可能性があります。再生成時には今回の変更を反映してください。
- 以前のガーバーZIPは更新していません。今回の穴径を使う際は上記の新しいZIPを使用してください。
- KiCadを開いたままの場合は、変更後のファイルを読み直してください。

JLCPCBの現行公表条件では、元の0.25 / 0.45 mmも小径ビア追加料金が不要となる条件に含まれます。今回の変更による価格低下は保証しておらず、実際の見積もり・層数・製造オプションで確認が必要です。[公式料金条件を含む製造能力表](https://jlcpcb.com/capabilities/Capab)

この変更はビア寸法への対応です。回路図レビューで指摘したbaselineファームの出力衝突、LDO安定性などは未解決のままです。
