ramtuc/rp2040-logic-analyzer/hardware/out/completion/RESULT.md

# 配線仕上げ結果（2026-09-20）

対象: `hardware/rp2040-logic-analyzer.kicad_pcb`。指定の `.kicad_pro` から開く基板へ反映済み。

## 検証結果

KiCad 10.0.3 の DRC を、ゾーン再充填・回路図との比較を有効にして実行。

| 項目 | 作業前 | 完了後 |
| --- | ---: | ---: |
| 未接続 | 211 | 0 |
| DRCエラー（未接続を除く） | 0 | 0 |
| 配線・ビア合計 | 38 | 959 |
| 部品数 | 82 | 82 |

完了後は配線778区間、ビア181個。元の38本の配線・ビアについて、UUID、座標、線幅、層、ネットがすべて維持されていることを確認。部品配置・パッドのネット割り当て・回路図・プロジェクト設定は変更していない。

既存の途中版を照合して配線を引き継ぎ、残った信号・電源接続を追加。細ピンの引き出しは最小0.15 mmとし、余裕のある区間は信号0.20 mm、電源最大0.50 mmへ拡幅した。元のUSB配線は維持。L2のGND、L3の電源構成を保ち、裏面GNDベタと外周GNDビア22個を追加した。設計ルールやDRCの重大度を緩和していない。

## 残る警告

- シルクに関する警告47件: 基板端5件、マスクとの重なり8件、シルク同士の重なり34件。
- 回路図との属性差9件: TP1〜TP9の「部品表から除外」の設定差。接続の不一致ではなく、作業前から存在する。

今回の完了範囲は配線と接続・クリアランスの検証。発注前にはシルクとBOM属性を整理すること。DRCは実機動作や信号品質の保証ではない。水晶周辺には層間接続が残るため、試作で発振・起動を確認する必要がある。

## 保存先

- 反映先: `../../rp2040-logic-analyzer.kicad_pcb`
- 最終DRC: `../../rp2040-logic-analyzer.drc.json`
- 元データのバックアップ: `original-before-routing/`（PCB・回路図・プロジェクト）
- 配線確認用画像: `finished-preview.png`（表裏配線の重ね表示。ベタ・シルクは省略）
- 作業用の中間版・スクリプトは `hardware/out/` に保存。

KiCadで元の基板を開いたままの場合は、古い画面の内容で上書きせず、保存せず閉じてからプロジェクトを開き直す。
