ramtuc/rp2040-logic-analyzer/hardware/rp2040-logic-analyzer.kicad_pcb

## KiCad design hardware/rp2040-logic-analyzer.kicad_pcb (2026-10-10)

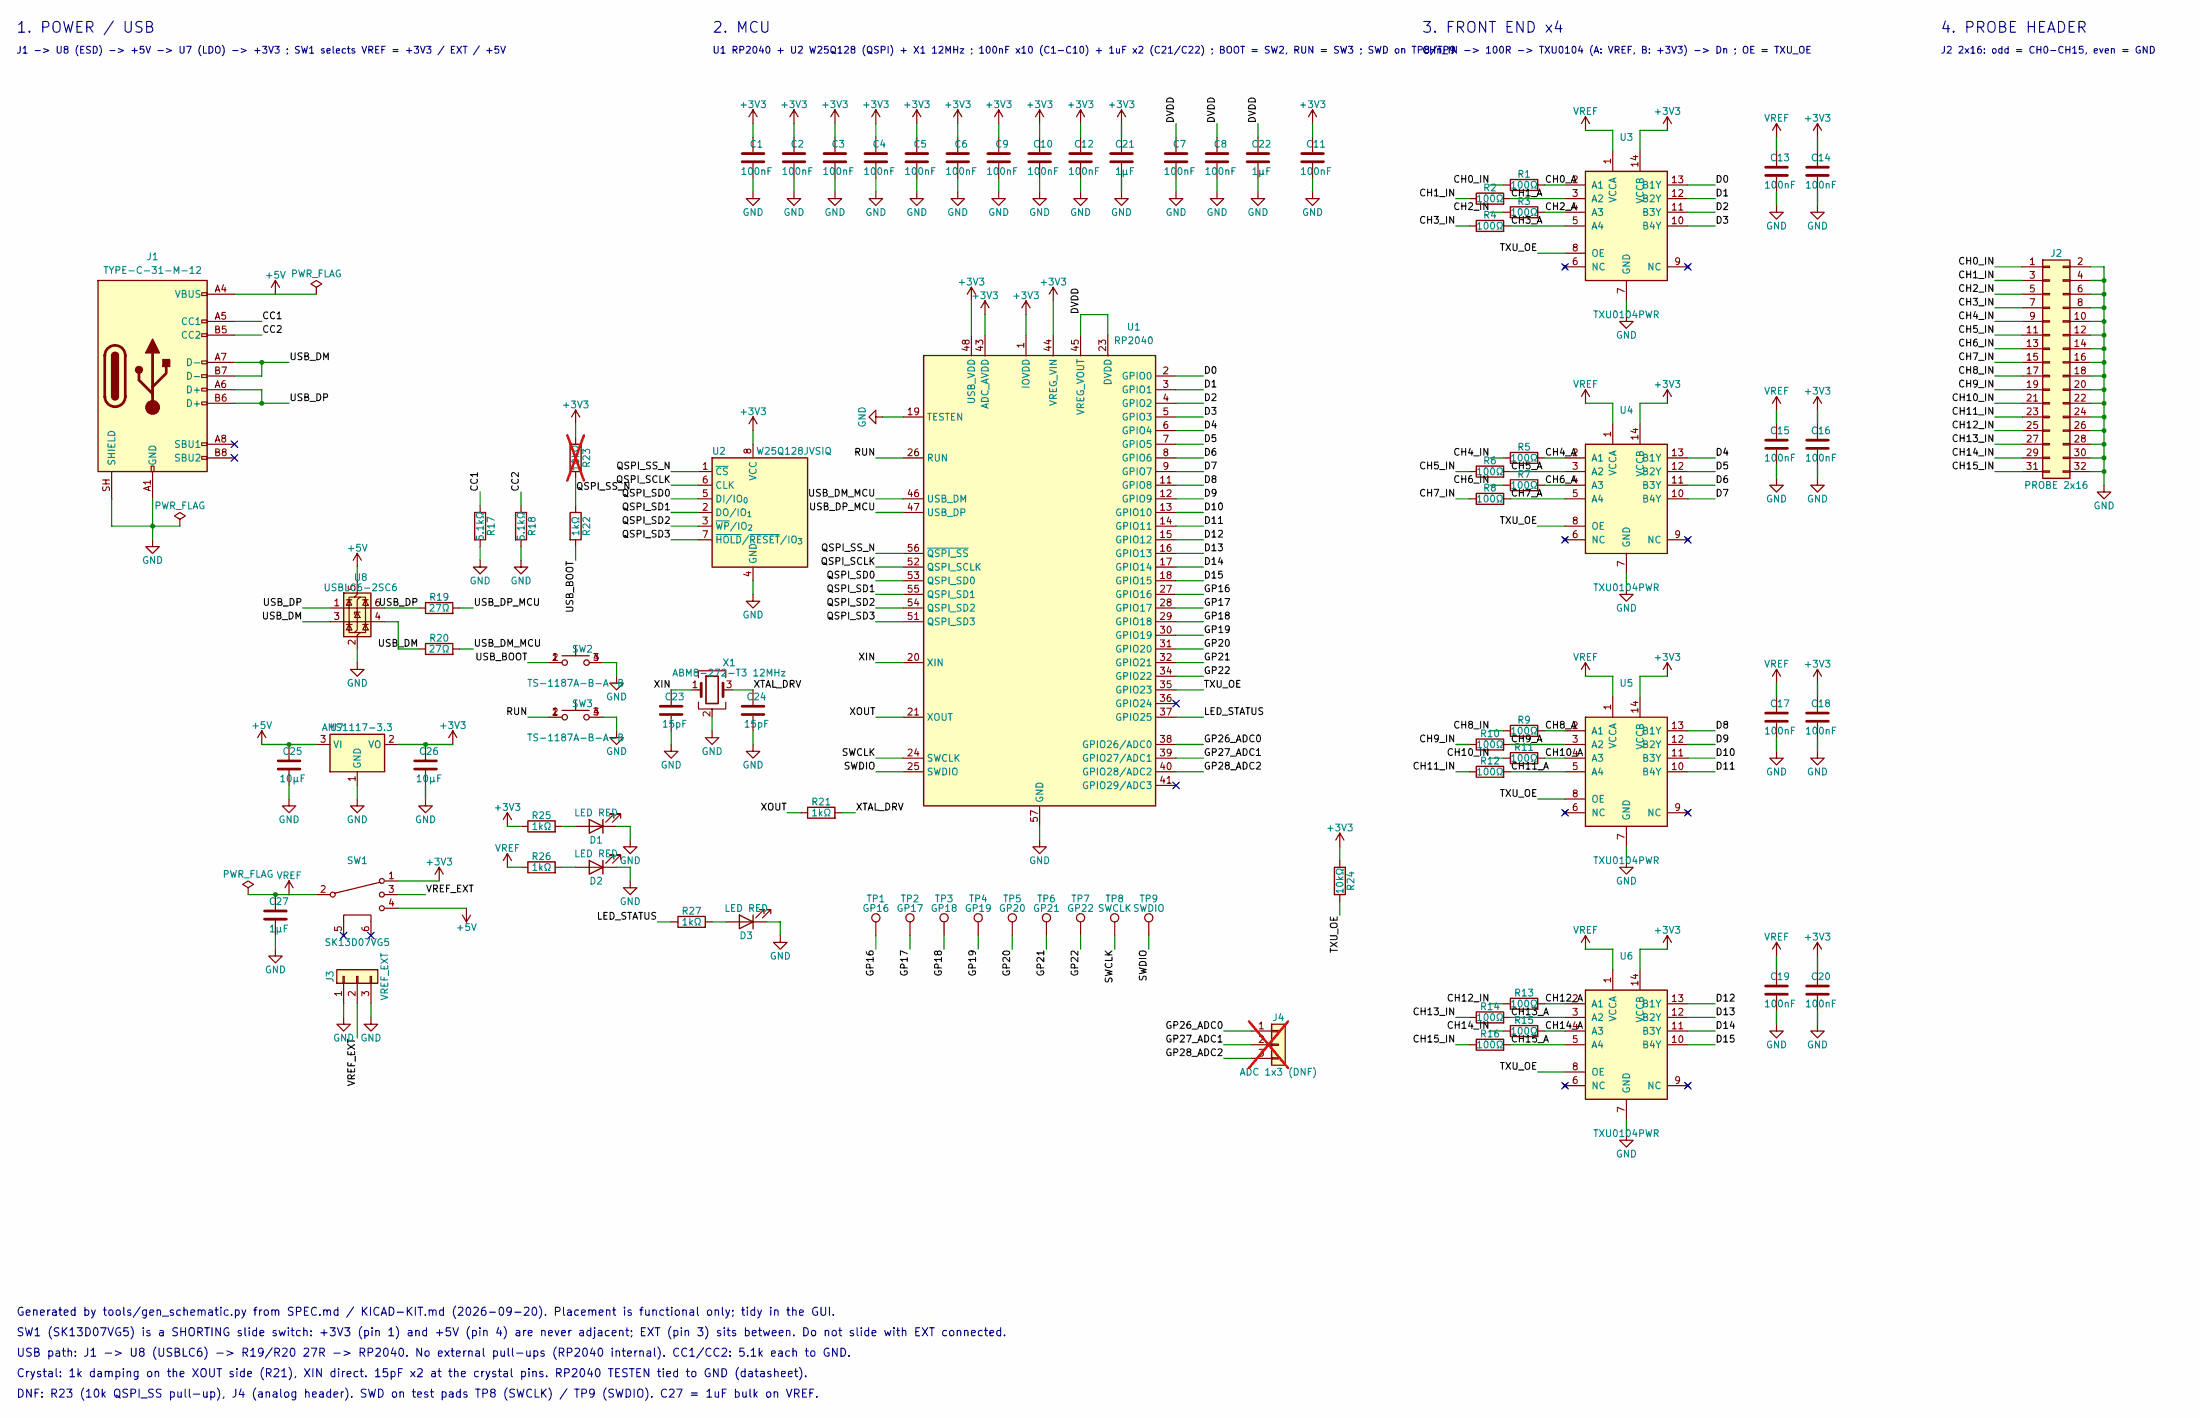
[picture p9: schematic rp2040-logic-analyzer.kicad_sch, RP2040 16ch Logic Analyzer]

Parts:
C1, C2, C3, C4, C5, C6, C7, C8, C9, C10, C11, C12, C13, C14, C15, C16, C17, C18, C19, C20: 100nF; C_0402_1005Metric
C21, C22, C27: 1µF; C_0402_1005Metric
C23, C24: 15pF; C_0402_1005Metric
C25, C26: 10µF; C_0805_2012Metric
D1, D2, D3: LED RED; LED_0603_1608Metric; LCSC Part # C2286
J1: TYPE-C-31-M-12; USB_C_Receptacle_HRO_TYPE-C-31-M-12; LCSC Part # C165948
J2: PROBE 2x16; PinHeader_2x16_P2.54mm_Vertical
J3: VREF_EXT; PinHeader_1x03_P2.54mm_Vertical
J4: ADC 1x3 (DNF); PinHeader_1x03_P2.54mm_Vertical; not fitted
R1, R2, R3, R4, R5, R6, R7, R8, R9, R10, R11, R12, R13, R14, R15, R16: 100Ω; R_0402_1005Metric
R17, R18: 5.1kΩ; R_0402_1005Metric
R19, R20: 27Ω; R_0402_1005Metric
R21, R22, R25, R26, R27: 1kΩ; R_0402_1005Metric
R23: 10kΩ; R_0402_1005Metric; not fitted
R24: 10kΩ; R_0402_1005Metric
SW1: SK13D07VG5; SW-TH_SK13D07VG5; LCSC Part # C393948
SW2, SW3: TS-1187A-B-A-B; SW-SMD_4P-L5.1-W5.1-P3.70-LS6.5-TL_H1.5; LCSC Part # C318884
TP1: GP16; TestPoint_Pad_1.0x1.0mm
TP2: GP17; TestPoint_Pad_1.0x1.0mm
TP3: GP18; TestPoint_Pad_1.0x1.0mm
TP4: GP19; TestPoint_Pad_1.0x1.0mm
TP5: GP20; TestPoint_Pad_1.0x1.0mm
TP6: GP21; TestPoint_Pad_1.0x1.0mm
TP7: GP22; TestPoint_Pad_1.0x1.0mm
TP8: SWCLK; TestPoint_Pad_1.0x1.0mm
TP9: SWDIO; TestPoint_Pad_1.0x1.0mm
U1: RP2040; QFN-56-1EP_7x7mm_P0.4mm_EP3.2x3.2mm; LCSC Part # C2040
U2: W25Q128JVSIQ; SOIC-8_5.3x5.3mm_P1.27mm; LCSC Part # C97521
U3, U4, U5, U6: TXU0104PWR; TSSOP-14_4.4x5mm_P0.65mm; LCSC Part # C2938871
U7: AMS1117-3.3; SOT-223-3_TabPin2; LCSC Part # C6186
U8: USBLC6-2SC6; SOT-23-6; LCSC Part # C7519
X1: ABM8-272-T3 12MHz; Crystal_SMD_3225-4Pin_3.2x2.5mm; LCSC Part # C20625731

Connections:
+3V3: C1.1, C2.1, C3.1, C4.1, C5.1, C6.1, C9.1, C10.1, C11.1, C12.1, C14.1, C16.1, C18.1, C20.1, C21.1, C26.1, R23.1, R24.1, R25.1, SW1.1, U1.1 (IOVDD), U1.10 (IOVDD), U1.22 (IOVDD), U1.33 (IOVDD), U1.42 (IOVDD), U1.43 (ADC_AVDD), U1.44 (VREG_VIN), U1.48 (USB_VDD), U1.49 (IOVDD), U2.8 (VCC), U3.14 (VCCB), U4.14 (VCCB), U5.14 (VCCB), U6.14 (VCCB), U7.2 (VO)
+5V: C25.1, J1.A4 (VBUS), J1.A9 (VBUS), J1.B4 (VBUS), J1.B9 (VBUS), SW1.4, U7.3 (VI), U8.5 (VBUS)
/CC1: J1.A5 (CC1), R17.1
/CC2: J1.B5 (CC2), R18.1
/CH0_A: R1.2, U3.2 (A1)
/CH0_IN: J2.1, R1.1
/CH1_A: R2.2, U3.3 (A2)
/CH1_IN: J2.3, R2.1
/CH2_A: R3.2, U3.4 (A3)
/CH2_IN: J2.5, R3.1
/CH3_A: R4.2, U3.5 (A4)
/CH3_IN: J2.7, R4.1
/CH4_A: R5.2, U4.2 (A1)
/CH4_IN: J2.9, R5.1
/CH5_A: R6.2, U4.3 (A2)
/CH5_IN: J2.11, R6.1
/CH6_A: R7.2, U4.4 (A3)
/CH6_IN: J2.13, R7.1
/CH7_A: R8.2, U4.5 (A4)
/CH7_IN: J2.15, R8.1
/CH8_A: R9.2, U5.2 (A1)
/CH8_IN: J2.17, R9.1
/CH9_A: R10.2, U5.3 (A2)
/CH9_IN: J2.19, R10.1
/CH10_A: R11.2, U5.4 (A3)
/CH10_IN: J2.21, R11.1
/CH11_A: R12.2, U5.5 (A4)
/CH11_IN: J2.23, R12.1
/CH12_A: R13.2, U6.2 (A1)
/CH12_IN: J2.25, R13.1
/CH13_A: R14.2, U6.3 (A2)
/CH13_IN: J2.27, R14.1
/CH14_A: R15.2, U6.4 (A3)
/CH14_IN: J2.29, R15.1
/CH15_A: R16.2, U6.5 (A4)
/CH15_IN: J2.31, R16.1
/D0: U1.2 (GPIO0), U3.13 (B1Y)
/D1: U1.3 (GPIO1), U3.12 (B2Y)
/D2: U1.4 (GPIO2), U3.11 (B3Y)
/D3: U1.5 (GPIO3), U3.10 (B4Y)
/D4: U1.6 (GPIO4), U4.13 (B1Y)
/D5: U1.7 (GPIO5), U4.12 (B2Y)
/D6: U1.8 (GPIO6), U4.11 (B3Y)
/D7: U1.9 (GPIO7), U4.10 (B4Y)
/D8: U1.11 (GPIO8), U5.13 (B1Y)
/D9: U1.12 (GPIO9), U5.12 (B2Y)
/D10: U1.13 (GPIO10), U5.11 (B3Y)
/D11: U1.14 (GPIO11), U5.10 (B4Y)
/D12: U1.15 (GPIO12), U6.13 (B1Y)
/D13: U1.16 (GPIO13), U6.12 (B2Y)
/D14: U1.17 (GPIO14), U6.11 (B3Y)
/D15: U1.18 (GPIO15), U6.10 (B4Y)
/DVDD: C7.1, C8.1, C22.1, U1.23 (DVDD), U1.45 (VREG_VOUT), U1.50 (DVDD)
/GP16: TP1.1, U1.27 (GPIO16)
/GP17: TP2.1, U1.28 (GPIO17)
/GP18: TP3.1, U1.29 (GPIO18)
/GP19: TP4.1, U1.30 (GPIO19)
/GP20: TP5.1, U1.31 (GPIO20)
/GP21: TP6.1, U1.32 (GPIO21)
/GP22: TP7.1, U1.34 (GPIO22)
/GP26_ADC0: J4.1, U1.38 (GPIO26/ADC0)
/GP27_ADC1: J4.2, U1.39 (GPIO27/ADC1)
/GP28_ADC2: J4.3, U1.40 (GPIO28/ADC2)
/LED_STATUS: R27.1, U1.37 (GPIO25)
/QSPI_SCLK: U1.52 (QSPI_SCLK), U2.6 (CLK)
/QSPI_SD0: U1.53 (QSPI_SD0), U2.5 (DI/IO_{0})
/QSPI_SD1: U1.55 (QSPI_SD1), U2.2 (DO/IO_{1})
/QSPI_SD2: U1.54 (QSPI_SD2), U2.3 (~WP/IO_{2})
/QSPI_SD3: U1.51 (QSPI_SD3), U2.7 (~HOLD/~RESET/IO_{3})
/QSPI_SS_N: R22.1, R23.2, U1.56 (~QSPI_SS), U2.1 (~CS)
/RUN: SW3.1 (A), SW3.2 (B), U1.26 (RUN)
/SWCLK: TP8.1, U1.24 (SWCLK)
/SWDIO: TP9.1, U1.25 (SWDIO)
/TXU_OE: R24.2, U1.35 (GPIO23), U3.8 (OE), U4.8 (OE), U5.8 (OE), U6.8 (OE)
/USB_BOOT: R22.2, SW2.1 (A), SW2.2 (B)
/USB_DM: J1.A7 (D-), J1.B7 (D-), R20.1, U8.3 (I/O2), U8.4 (I/O2)
/USB_DM_MCU: R20.2, U1.46 (USB_DM)
/USB_DP: J1.A6 (D+), J1.B6 (D+), R19.1, U8.1 (I/O1), U8.6 (I/O1)
/USB_DP_MCU: R19.2, U1.47 (USB_DP)
/VREF_EXT: J3.2, SW1.3
/XIN: C23.1, U1.20 (XIN), X1.1
/XOUT: R21.1, U1.21 (XOUT)
/XTAL_DRV: C24.1, R21.2, X1.3
GND: C1.2, C2.2, C3.2, C4.2, C5.2, C6.2, C7.2, C8.2, C9.2, C10.2, C11.2, C12.2, C13.2, C14.2, C15.2, C16.2, C17.2, C18.2, C19.2, C20.2, C21.2, C22.2, C23.2, C24.2, C25.2, C26.2, C27.2, D1.1 (K), D2.1 (K), D3.1 (K), J1.A1 (GND), J1.A12 (GND), J1.B1 (GND), J1.B12 (GND), J1.SH (SHIELD), J2.2, J2.4, J2.6, J2.8, J2.10, J2.12, J2.14, J2.16, J2.18, J2.20, J2.22, J2.24, J2.26, J2.28, J2.30, J2.32, J3.1, J3.3, R17.2, R18.2, SW2.3 (C), SW2.4 (D), SW3.3 (C), SW3.4 (D), U1.19 (TESTEN), U1.57 (GND), U2.4 (GND), U3.7 (GND), U4.7 (GND), U5.7 (GND), U6.7 (GND), U7.1 (GND), U8.2 (GND), X1.2 (G), X1.4 (G)
unnamed: D1.2 (A), R25.2
unnamed: D2.2 (A), R26.2
unnamed: D3.2 (A), R27.2
VREF: C13.1, C15.1, C17.1, C19.1, C27.1, R26.1, SW1.2 (COM), U3.1 (VCCA), U4.1 (VCCA), U5.1 (VCCA), U6.1 (VCCA)

Notes on the sheet:
Generated by tools/gen_schematic.py from SPEC.md / KICAD-KIT.md (2026-09-20). Placement is functional only; tidy in the GUI.
J1 -> U8 (ESD) -> +5V -> U7 (LDO) -> +3V3 ; SW1 selects VREF = +3V3 / EXT / +5V
USB path: J1 -> U8 (USBLC6) -> R19/R20 27R -> RP2040. No external pull-ups (RP2040 internal). CC1/CC2: 5.1k each to GND.
SW1 (SK13D07VG5) is a SHORTING slide switch: +3V3 (pin 1) and +5V (pin 4) are never adjacent; EXT (pin 3) sits between. Do not slide with EXT connected.
4. PROBE HEADER
CHn_IN -> 100R -> TXU0104 (A: VREF, B: +3V3) -> Dn ; OE = TXU_OE
2. MCU
1. POWER / USB
J2 2x16: odd = CH0-CH15, even = GND
U1 RP2040 + U2 W25Q128 (QSPI) + X1 12MHz ; 100nF x10 (C1-C10) + 1uF x2 (C21/C22) ; BOOT = SW2, RUN = SW3 ; SWD on TP8/TP9
3. FRONT END x4
DNF: R23 (10k QSPI_SS pull-up), J4 (analog header). SWD on test pads TP8 (SWCLK) / TP9 (SWDIO). C27 = 1uF bulk on VREF.
Crystal: 1k damping on the XOUT side (R21), XIN direct. 15pF x2 at the crystal pins. RP2040 TESTEN tied to GND (datasheet).

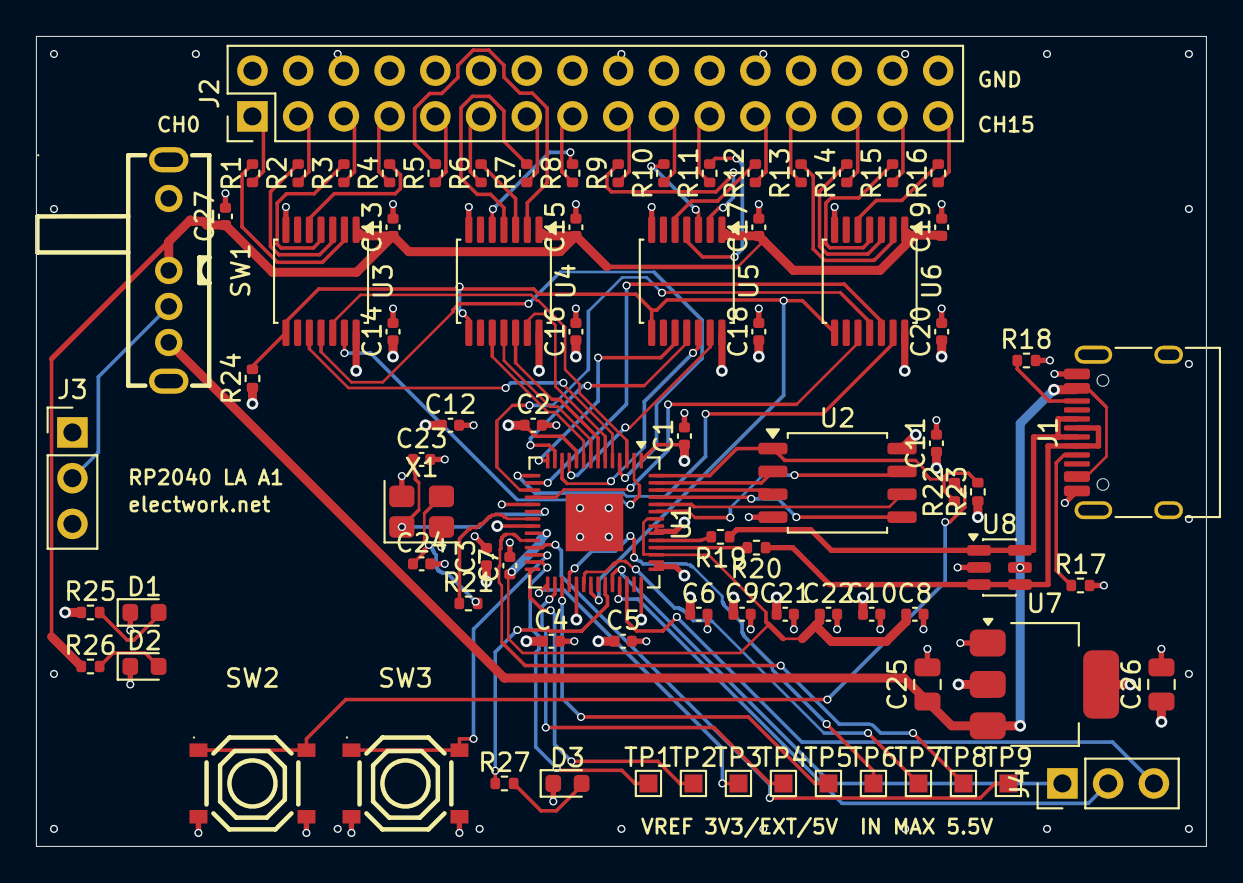
[picture p10: board rp2040-logic-analyzer.kicad_pcb from above]

Board: 4 copper layers, 65.0 x 45.0 mm, 82 parts (0 on the bottom side), 88 nets.
