ramtuc/rp2040-logic-analyzer/(commit log)

2026-09-09 SPEC: RP2040 16ch ロジックアナライザ基板の設計仕様（JLCPCB コラボ第1弾）
    - ファームウェア基盤を4候補で比較し sigrok-pico を推奨（唯一の libsigrok
    ネイティブドライバ・最終push 2026-08-07）。μLA を保険に置く
    - ピン割り当てを GP0-GP15 にすることで sigrok-pico / μLA / dgatf の
    3ファームが無改造で動く配置にした
    - 入力フロントエンドは TXU0104PWR ×4（Schmitt入力・内蔵プルダウン・
    1.08〜5.5V）。RP2040 の VIH=2.0V のため直結では 1.8V を読めない
    - BOM は LCSC 型番と JLCPCB Basic/Extended 区分つき（Extended 4種）
    - PCBA 費用は公式料金ページ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
2026-09-09 SPEC: オシロを OWON VDS3102L に確定し §11 実機チェックリストを 2ch 前提で再構成
    - §11 にフェーズ 0（測定器の限界）を追加。公式マニュアル §IV より
    2ch 同時 500MS/s / 1ch 1GS/s、立ち上がり ≤3.5ns、ΔT 確度、
    MULTI 端子はトリガ専用、×1 プローブは帯域 5MHz を確定
    - フェーズ 5 を 2ch 割り当て付きで再構成。ch 間スキューは 22a/22b に分割、
    プローブ校正出力（3.3V/1kHz）を使う先行導通確認を追加
    - フェーズ 6 も 2ch 前提に。SPI は SCK+MOSI / SCK+MISO の 2 回に分割
    - §14-9 缶発振器を 25MHz・3.3V CMOS に確定（50MHz は 3 次高調波が帯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
2026-09-09 KiCad 着手キットを追加（KICAD-KIT.md ＋ lib/）
    - KICAD-KIT.md: 部品所在表・BOM/CPL 運用・JLCPCB 4層 DRC・ネット名と
    シート構成・回路図チェックリスト 15 項目
    - 所在表は KiCad 10.0 の実インストールを直接検索して確認。BOM 16 種のうち
    標準で足りないのは 3 件（TXU0104PWR のシンボル、スイッチ 2 種のフットプリント）
    - lib/logicana.*: easyeda2kicad で LCSC から取り込み、kicad-cli fp/sym upgrade で
    KiCad 10 形式へ変換。TXU0104PWR のピン配置は TI SCES937B Table 4-1 と一致を確認
    - スタックアップは JLC04161H-7628（合計 1.586mm ≒ 1.6mm を検算）
    - USB 90Ω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
2026-09-09 KiCad 着手キットの仕上げ: TXU0104 シンボル自作・SW1 確定・水晶ダンピング抵抗の位置確定
    - lib/logicana.kicad_sym を TI SCES937B Table 4-1 から自作した TXU0104PWR
    1 個だけに。FP は KiCad 標準 Package_SO:TSSOP-14_4.4x5mm_P0.65mm
    （TI 推奨ランド 0.65 ピッチ / 列間 5.8mm と照合済み）
    - LCSC/EasyEDA 由来は lib/lcsc/ に集約し .gitignore。3D パスは
    --project-relative で ${KIPRJMOD} 相対に取り直し。.step は非同梱
    - SW1: メーカー図面で 3 点確定。パッド 4/2/2mm は正しい・コモンはピン1・
    SHORTING 型。接点の並びを 3.3V - EXT - 5V にする制約を追加（+3V3 と
    +5V の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
2026-09-19 回路図 第1版を生成スクリプトで作成（KiCad 10・ERC 0・ネット照合 86/86）
    - tools/gen_schematic.py: SPEC/KICAD-KIT から .kicad_sch を生成（冪等・selftest 付き）
    - tools/verify_netlist.py / check_kit5.py: ネット照合と KIT §5 の機械検査
    - hardware/: .kicad_pro / .kicad_sch / lib テーブル / out（PDF・BOM・検証結果）
    - lib/logicana.kicad_sym: SW1（SP3T shorting・物理ピン番号）と SW2/3（TS-1187A 4 パッド）の自作シンボル追加
    Claude-Session: https://claude.ai/code/session_01QcyfLK5Dm75FgDGZMr6fff
    [bom-flat.csv, bom-grouped.csv, bom-jlcpcb.csv, rp2040-logic-analyzer.kicad_sch]
2026-09-19 gitignore: __pycache__ を除外
    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
2026-09-19 SPEC/KIT/README を回路図第1版の実態に更新（スイッチ自作シンボル・TP1〜TP9・C27・パス・再現手順）
    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
2026-09-19 PCB 第1版: 配置済み・未配線の基板と生成/配線/出力ツール（回路図に TP8/TP9・C27 追加）
    - tools/gen_pcb.py: ネットリストから .kicad_pcb を生成（4層 JLC04161H-7628・KIT §3 の DRC/ネットクラス・配置表・USB 差動手配線・内層 GND/+3V3 plane）
    - tools/route_pcb.py: freerouting 駆動（--input で人間の版・--pours-only で配線後に B.Cu GND ベタ）
    - tools/make_outputs.py: DRC → Gerber/Drill/CPL/zip/render（未実行・人間の配線後）
    - hardware/: 配置済み基板（DRC error 0・未配線 192＝配線前）。out/placed・out/route（freerouting 試行の参考）
    - 回路図: TP8=SWCLK・TP9=SWDIO・C27 1µF(V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
    [bom-flat.csv, bom-grouped.csv, bom-jlcpcb.csv, rp2040-logic-analyzer.kicad_pcb, rp2040-logic-analyzer.kicad_sch]
2026-09-20 人間の GUI 編集を取り込み（PCB: 微細ピッチのファンアウト配線 10 本＋ビア 5・回路図の整形）
    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
    [rp2040-logic-analyzer.kicad_pcb, rp2040-logic-analyzer.kicad_sch]
2026-09-20 PCB 第3工程: ファンアウト＋freerouting＋GND ベタの最良版（DRC error 0・未配線 19）とツール
    - tools/fanout_planes.py: GND/+3V3 の SMD パッドから内層プレーンへのファンアウトビア（--lock-existing）
    - tools/route_pcb.py: ヘッドレス実行・DSN の wire_keepout 除去・配線座標の 0.1µm 書き直し（freerouting が読めない原因を修正）
    - tools/finish_pcb.py: 欠片除去・B.Cu GND ベタ・外周ビアスティッチ
    - hardware/out/step3/03-final-E.*: 最良版（人間の配線は locked で不変）。未配線 19 本の表は handoff t-6d9aa259 §4
    Claud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
    [03-final-E.kicad_pcb, 03-final-E.kicad_sch]
2026-09-20 PCB 配線完了（人間の GUI 作業＋補助スクリプト）: DRC error 0・未配線 0
    - hardware/rp2040-logic-analyzer.kicad_pcb: 配線 778 本・ビア 182・ゾーン 5。kicad-cli drc --refill-zones --schematic-parity で error 0 / unconnected 0（warning は silk 47 件のみ・parity は TP の BOM 除外差 9 件）
    - hardware/out/: 配線完了に使った補助スクリプトと記録（RESULT.md・ground-finish.md・preview）。試行物と jar は gitignore
    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
    [rp2040-logic-analyzer.kicad_pcb]
2026-09-20 製造データ一式: Gerber/Drill/zip・CPL（J1 含む 68 行）・JLCPCB BOM（LCSC 付き 19 行・汎用 R/C は Basic 品番）・照合表
    - tools/make_outputs.py: CPL は基板 attr で SMD だけ残す（THT 固定ピン付き SMD コネクタが --exclude-fp-th で落ちる問題）・BOM は回路図から LCSC 付き・範囲表記なし・LCSC_FILL で汎用 R/C を補完・bom-cpl-check.md
    - hardware/out/: gerbers/ zip cpl-jlcpcb.csv bom-jlcpcb.csv bom-cpl-check.md cpl-rotation-report.md render
    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
    [bom-grouped.csv, bom-jlcpcb.csv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]
2026-09-20 回路図レビューへの対応（文書のみ）: baseline 使用禁止・AMS1117 出力コンデンサの既知リスク・SW1 運用制約・dgatf GP18/19 修正・§10 汎用部品の JLCPCB 品番
    - hardware/out/review/: レビュー報告（REVIEW.md・証拠）と回答（RESPONSE.md）・review_schematic.py
    - SPEC §2.3/§4.4/§5.3/§6.1(新設)/§7/§10/§11/§14、KICAD-KIT §1.2.3/§7、README
    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
2026-09-21 Gerber 再出力（2026-09-20 16:56・内容同一・作成日時のみ）と JLCPCB アップロード用 gerbers.zip
    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
    [rp2040-logic-analyzer-B_Cu.gbl, rp2040-logic-analyzer-B_Mask.gbs, rp2040-logic-analyzer-B_Paste.gbp, rp2040-logic-analyzer-B_Silkscreen.gbo, rp2040-logic-analyzer-Edge_Cuts.gm1, rp2040-logic-analyzer-F_Cu.gtl, rp2040-logic-analyzer-F_Mask.gts, rp2040-logic-analyzer-F_Paste.gtp]
2026-09-22 ビア穴を 0.25→0.3 に変更（JLCPCB 標準オプション 0.3mm/(0.4/0.45mm) に合わせる・人間の GUI 作業）と製造データ再出力
    - 信号系ビア 148 個: 0.45/0.3・電源系 33 個: 0.65/0.35 のまま。Board Setup の最小アニュラリングを 0.075 に
    - DRC error 0・未配線 0（warning は silk 47 のまま）。drill 最小 T1C0.300
    - hardware/out: Gerber/Drill/zip/CPL/BOM/照合表を再生成。JLCPCB にアップロード済み・企画案送信済み（2026-09-21）
    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
    [original.kicad_pcb, original.kicad_sch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]
2026-10-03 SW1（SK13D07VG5）のコモンをピン 2 に訂正: シンボルのピン番号・SPEC §5.4/§17・KICAD-KIT・tools の期待値・図を更新（実測 2026-10-04）
    [rp2040-logic-analyzer.kicad_sch]
2026-10-03 SPEC §17: SW1 コモン違いの発見時系列を実際どおりに訂正（USB 給電後に導通確認・位置 2/3 は未使用）
2026-10-04 公開向け README（JA＋EN）・SPEC の非公開化（企画案文面・メール）・hardware/jlcpcb/ 正規データ置き場・freerouting ログを除外
2026-10-04 hardware/jlcpcb: JLCPCB からダウンロードした Gerber 一式（16 ファイル）とプレビュー画像を正規データとして追加
    - gerbers/: A0 の注文（2026-09-26）で製造に使われた Gerber・ドリル（KiCad 10.0.3・2026-09-21 22:40 出力）
    - ../out/gerbers との違いは出力日時と長穴 6 か所の記法（G00/M15/G01/M16 と G85）だけ
    - BOM/CPL は未配置（注文ページからの取得待ち）
    - JLCPCB 内部の CAM 出力（ok/）と解析 JSON は同梱しない
    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
    [rp2040-logic-analyzer-B_Cu.gbl, rp2040-logic-analyzer-B_Mask.gbs, rp2040-logic-analyzer-B_Paste.gbp, rp2040-logic-analyzer-B_Silkscreen.gbo, rp2040-logic-analyzer-Edge_Cuts.gm1, rp2040-logic-analyzer-F_Cu.gtl, rp2040-logic-analyzer-F_Mask.gts, rp2040-logic-analyzer-F_Paste.gtp]
2026-10-04 hardware/jlcpcb: 注文時にアップロードした BOM / CPL を正規データとして追加（人間決定）・README の説明を更新
    - bom-jlcpcb.csv / cpl-jlcpcb.csv は ../out/ の同名ファイルと同一（A0 の注文に使ったもの）
    - hardware/jlcpcb/README.md と直下 README の「ダウンロードした BOM/CPL」の記述を実態に合わせた
    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
    [bom-jlcpcb.csv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]
2026-10-10 tools: UNO R4 WiFi GPT clock source for sampling-rate tests (12/16/24/1 MHz on D6)
    - PwmOut raw mode (period/pulse counts, PCLKD 48 MHz); 24 MHz noted as outside
    the RA4M1 manual's 0 < GTCCRA < GTPR range, 16 MHz is 67% duty
    - README: frequency table, manual citations, HOCO ±1%, wiring (D6 -> CH0, SW1 = 5V)
    - compile-checked with arduino-cli 1.5.1 / renesas_uno 1.5.2 (unor4wifi, minima)
    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
2026-10-10 tools: UNO R4 WiFi test sketches for SPI/UART (74HC595 + Serial1) and servo PWM
    - uno-r4-spi-uart: 0x0F to 74HC595 via shiftOut or HW SPI 1 MHz, Serial1 text at UART_BAUD
    - uno-r4-servo: SG90 on D9, 0/90/180 deg every 2 s (attach 500-2400 us)
    - both verified on the board with the logic analyzer (article #3 session 2)
    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
2026-10-10 Add licenses (CERN-OHL-P-2.0 hardware, MIT software) and JLCPCB ordering guide in README
    - LICENSE: CERN Open Hardware Licence v2 Permissive (official text, unmodified)
    - LICENSE-MIT: tools/ scripts and Arduino sketches
    - README: status after article #3 measurements, ordering steps (JA/EN), SW1 A0 warning,
    tools/ layout, license notice with source location
    - untrack hardware/out/route/run.json (local user path)
    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
2026-10-10 A1: fix SW1 net assignment (pad1=+3V3, pad2=VREF) and regenerate manufacturing data
    - PCB: SW1 pad1/pad2 nets now match the corrected schematic (COM = pad2);
    VREF trace re-routed to pad2, In2 +3V3 plane refilled; silk "RP2040 LA A1",
    back silk "CERN-OHL-P v2"; title block rev A1
    - DRC 0 errors / 0 unconnected (47 silk warnings as A0), ERC 0,
    schematic<->board net check 88/88, KIT check 17/17
    - hardware/jlcpcb/ now holds A1 (Gerber 16, BOM 19, CPL 68); A0 order data moved to a0/
    - make_outputs.py: explicit --excellon-oval-format route (same drill notation as the
    A0 production files); new tools/verify_pcb_netlist.py
    - README/SPEC: A1 is untested (not yet manufactured); A0 verified with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
    [bom-jlcpcb.csv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]
2026-10-10 Publish A1 only: remove the A0 order data folder and its README references
    - hardware/jlcpcb/ now contains only the Rev A1 manufacturing data (the A0 files
    remain in git history); READMEs keep the A0 known-issue and order history
    but no longer offer the A0 data
    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
    [bom-jlcpcb.csv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]
