ramtuc/rp2040-logic-analyzer/(notices)

Notices in the files:
parts and their libraries:
Tactile switch XKB TS-1187A-B-A-B (LCSC C318884), SMD 5.1x5.1mm, 4 pads. Pads 1+2 (A/B) are one contact and pads 3+4 (C/D) the other, per the XKB drawing; both pads of a contact are stacked on one symbol pin so all 4 pads get the net. Drawn by hand, CERN-OHL-P-2.0
